raonka/Pack-Puck/data/analysis/2026-08-15_GMATownship_184714_qc/unassigned/report.md

# QC report — run `unassigned` (static)

- Session dir: `data/ranging_experiments/2026-08-15_GMATownship_session01/raw/20260815_184714-Initiator`
- Generated: 2026-09-10 23:37 UTC by qc_session.py v1.0.0 (raw CSVs read-only, unmodified)
- Expected config: 2400.0 MHz, BW 1625.0 kHz, SF8, CR 4/7, 12 dBm; N=100/file; cadence 655.0 ms ±5%; drift limit 15.0 m; warm-up window 5.0 s
- Ground truth: session plan `session_plan.json` (operator-supplied; used only where CSV line-2 TRUE_DISTANCE_M is absent)

## Verdict: **PASS**

No machine-checkable Methodology §11 discard trigger found in this run.

> The following Methodology §11 discard criteria are **not machine-checkable from CSVs** and must be confirmed against the session log: (a) cone moved mid-session without re-measurement; (b) material weather change mid-session (rain start, wind category shift). This tool checks only: firmware reboot / power-loss evidence (short or truncated files), and the >10-consecutive-ERROR abort criterion.

## 1. Manifest integrity

| file | manifest expected | manifest actual | on-disk | status | ok |
|---|---|---|---|---|---|
| `pucklog_D4DB1C_13.csv` | 237 | 237 | 237 | OK | ✓ |

## 2. Per-file checks

| file | truth (src) | N | vs spec | cadence ms | S / T / E (rate) | max ERR streak | drift m | flags |
|---|---|---|---|---|---|---|---|---|
| `pucklog_D4DB1C_13.csv` | — | 0 | -100 | — | 0 (0%) / 0 (0%) / 0 (0%) | 0 | — | 2 |

All three outcomes count toward the attempt denominator.

### radio_status_code distribution (non-SUCCESS rows)

No non-SUCCESS rows in this run.

## 3. Warm-up (first 5 s vs remainder, SUCCESS rows)

| file | warm-up rows | warm-up median m | rest median m | delta m |
|---|---|---|---|---|
| `pucklog_D4DB1C_13.csv` | — | — | — | — |

Sanity check for the Methodology §7.2 first-5-s discard rule; large deltas indicate the discard window matters for that file.

## 4. Per-marker statistics (SUCCESS rows)

No SUCCESS rows / no marker-attributable data.

## 5. Deviations and anomalies

- `pucklog_D4DB1C_13.csv`: operator metadata line (line 2) absent — SITE/RUN_ID/TRUE_DISTANCE_M not recorded in file (Methodology §7.4 step incomplete)
- `pucklog_D4DB1C_13.csv`: no data rows (stub file — likely a boot into NORMAL mode with no ranging logged)

overview
