raonka/Pack-Puck/data/analysis/aggregates.md

# Pack Pucks — Campaign aggregates

Generated by `tools/aggregates.py`. **Numbers only.**

## Inputs

- Current (post-discard): `data/analysis/2026-08-22_GMATownship_day2_tables_discard5s.md` — TABLE 2 (static), TABLE 3 (stop-and-go)
- Superseded (pre-discard, comparison only): `data/analysis/2026-08-22_GMATownship_day2_qc_tables.md` — TABLE 2, TABLE 3
- Raw Initiator CSVs (cadence, exchange total):
  - `data/ranging_experiments/2026-08-15_GMATownship_session01/raw/20260815_184714-Initiator/` — 2100 rows
  - `data/ranging_experiments/2026-08-22_GMATownship_session02/raw/20260822_162424-Initiator/` — 3100 rows
  - `data/ranging_experiments/2026-08-22_GMATownship_session02/raw/20260822_174415-Initiator/` — 2660 rows

Definitions: MAE = mean over the ten markers of |per-marker median − marker|. Signed bias = mean of the same signed errors. Mean IQR = mean of per-marker IQRs. Ratios = 406.25 value / 1625 value. Current column: MAE, signed bias and MAE ratio from the unrounded per-marker medians (`tools/per_marker_tables.py`); mean IQR, IQR ratio, ranges, counts and worst marker from the tables' 0.1 m-rounded values. Pre-discard column: all from the 0.1 m-rounded tables (reproduces README.md).

## Accuracy and precision (22 Aug, matched session)

| aggregate | tier | post-discard (current) | pre-discard | README.md | changed at README precision? |
|---|---|---|---|---|---|
| MAE, 406.25 kHz | static | 11.1 m | 11.1 m | 11.1 m | no |
| MAE, 1625 kHz | static | 1.6 m | 1.7 m | 1.7 m | **yes** |
| MAE ratio 406.25 / 1625 | static | 6.8× | 6.7× | 6.7× | **yes** |
| MAE, 406.25 kHz | s&g | 12.1 m | 12.1 m | 12.1 m | no |
| MAE, 1625 kHz | s&g | 1.7 m | 1.7 m | 1.7 m | no |
| MAE ratio 406.25 / 1625 | s&g | 7.2× | 7.1× | 7.1× | **yes** |
| Signed bias, 406.25 kHz | static | +10.4 m | +10.5 m | +10.5 m | **yes** |
| Signed bias, 1625 kHz | static | +0.4 m | +0.4 m | +0.4 m | no |
| Signed bias, 406.25 kHz | s&g | +12.1 m | +12.1 m | +12.1 m | no |
| Signed bias, 1625 kHz | s&g | -0.2 m | -0.2 m | −0.2 m | no |
| Mean IQR, 406.25 kHz | static | 5.2 m | 5.2 m | 5.2 m | no |
| Mean IQR, 1625 kHz | static | 1.7 m | 1.7 m | 1.7 m | no |
| Mean IQR ratio 406.25 / 1625 | static | 3.1× | 3.0× | 3.0× | **yes** |
| Mean IQR, 406.25 kHz | s&g | 4.4 m | 4.5 m | 4.5 m | **yes** |
| Mean IQR, 1625 kHz | s&g | 1.8 m | 1.8 m | 1.8 m | no |
| Mean IQR ratio 406.25 / 1625 | s&g | 2.5× | 2.6× | 2.6× | **yes** |
| Markers with positive error, 406.25 kHz | static | 9 of 10 | 9 of 10 | 9 of 10 | no |
| Markers with positive error, 406.25 kHz | s&g | 10 of 10 | 10 of 10 | 10 of 10 | no |
| Max |error|, 1625 kHz (README: "inside ±5 m at every marker") | static | 3.2 m | 3.2 m | < 5 m | no |
| Max |error|, 1625 kHz (README: "inside ±5 m at every marker") | s&g | 4.8 m | 4.8 m | < 5 m | no |
| Worst single marker, 406.25 kHz | static | +29.7 m (at 240 m) | +29.9 m (at 240 m) | +29.9 m (at 240 m) | **yes** |
| Worst single marker, 1625 kHz | static | +3.2 m (at 240 m) | +3.2 m (at 240 m) | +3.2 m (at 240 m) | no |
| Per-marker IQR range, 406.25 kHz | both | 2.8–9.1 m | 2.7–8.5 m | 2.7–8.5 m | **yes** |
| Per-marker IQR range, 1625 kHz | both | 1.0–3.3 m | 0.9–3.3 m | 0.9–3.3 m | **yes** |

## Cadence and exchange count (raw CSVs; not affected by the discard)

| aggregate | value | README.md |
|---|---|---|
| Cycle time, 1625 kHz (pooled median, 2649 inter-row deltas, 22 Aug) | 655 ms | 655 ms (2,649 deltas) |
| Cycle time, 406.25 kHz (pooled median, 3084 inter-row deltas, 22 Aug) | 686 ms | 686 ms (3,084 deltas) |
| Cycle time p05 / p95, 1625 kHz (linear interpolation) | 655 / 660 ms | — |
| Cycle time p05 / p95, 406.25 kHz (linear interpolation) | 685 / 691 ms | — |
| Cycle-time cost of 406.25 vs 1625 | 4.7 % | 4.7 % |
| Cycle-time difference, 406.25 − 1625 | 31 ms | — |
| Bandwidth-scaled part of the 1625 kHz cycle, if it scales with symbol duration (×4 at 406.25): (686 − 655) / 3 | 10.3 ms | — |
| Bandwidth-independent remainder of the 1625 kHz cycle | 644.7 ms (98.4%) | — |
| Span of a causal 3-reading filter window (current and two previous readings = 2 cycles), 1625 kHz | 1310 ms | — |
| Span of a causal 3-reading filter window (current and two previous readings = 2 cycles), 406.25 kHz | 1372 ms | — |
| Ranging exchanges, both campaign outings (all Initiator rows in the canonical offload sets, discarded retakes included) | 7,860 | 7,860 |

## Changed vs the pre-discard / README values (at README display precision; includes the discard and, for MAE / signed bias / MAE ratio, the switch to unrounded per-marker values)

- MAE, 1625 kHz (static): 1.7 m → 1.6 m
- MAE ratio 406.25 / 1625 (static): 6.7× → 6.8×
- MAE ratio 406.25 / 1625 (s&g): 7.1× → 7.2×
- Signed bias, 406.25 kHz (static): +10.5 m → +10.4 m
- Mean IQR ratio 406.25 / 1625 (static): 3.0× → 3.1×
- Mean IQR, 406.25 kHz (s&g): 4.5 m → 4.4 m
- Mean IQR ratio 406.25 / 1625 (s&g): 2.6× → 2.5×
- Worst single marker 406.25 (static): +29.9 m (at 240 m) → +29.7 m (at 240 m)
- IQR range 406.25 (both tiers): 2.7–8.5 m → 2.8–9.1 m
- IQR range 1625 (both tiers): 0.9–3.3 m → 1.0–3.3 m

## Signed error vs distance, 406.25 kHz: least-squares line (post-discard)

Input: `data/analysis/2026-08-22_GMATownship_day2_tables_discard5s.md` TABLE 2 (static) and TABLE 3 (stop-and-go), column "406 err", against marker distance. Model: signed error = intercept + slope × distance. Numbers only.

| tier | markers | n | slope (m/m) | slope standard error (m/m) | intercept (m) | \|slope\| < standard error? |
|---|---|---|---|---|---|---|
| static | all ten | 10 | +0.0079 | 0.0339 | +9.10 | yes |
| static | without 240 m | 9 | -0.0150 | 0.0233 | +10.61 | yes |
| stop-and-go | all ten | 10 | +0.0042 | 0.0142 | +11.39 | yes |
| stop-and-go | without 240 m | 9 | +0.0006 | 0.0152 | +11.62 | yes |
