raonka/Pack-Puck/data/analysis/2026-08-15_GMATownship_day1_tables_discard5s.md

# Pack Pucks — Day 1 per-marker tables, warm-up discarded (2026-08-15, GMA township, 1625 kHz only)

Generated by `tools/per_marker_tables.py` (raw CSVs read-only, unmodified).

**Numbers only. No interpretation or conclusions are recorded in this file.**

## Discard rule (Methodology §7.2, applied 2026-10-10)

Every row whose `timestamp_ms` is ≤ 5 s after the first logged row of its window is dropped before any statistic is computed. Static window = the whole file (one boot per marker). Stop-and-go window = one dwell (see the per-run notes). `N` = post-discard attempts, all outcomes. `median`, `IQR` (Q3−Q1, linear interpolation), `RSSI` = SUCCESS rows. `err` = median − marker distance.

## Inputs

- `data/ranging_experiments/2026-08-15_GMATownship_session01/raw/20260815_184714-Initiator/`
- `data/analysis/2026-08-15_GMATownship_184714_qc/session_plan.json`

Ground-truth tolerance: OPEN (Methodology §5.3, OD-METH-3); every signed-error figure carries it. Timeout and ERROR counts are 0 in every window.

Supersedes, for every per-marker number: §4 of `2026-08-15_GMATownship_184714_qc/static/report.md` and §5 of `…/stop_and_go/report.md` (both kept unmodified as QC output).

Stop-and-go windows are HEURISTIC (`qc_session.py` plateau segmentation, default parameters, identical to the published report) — no operator arrival log exists for this run (S1 log D2). Static: the 330 m file is an off-set marker (S1 log D5/D6); there is no 300 m static file.

---

### 1625 kHz — static

| marker m | file | N (post-discard) | median m | Q1–Q3 m | IQR m | signed err m | median RSSI |
|---|---|---|---|---|---|---|---|
| 30 | `pucklog_D4DB1C_1.csv` | 62 | 32.1 | 31.5–32.6 | 1.2 | +2.1 | -70 |
| 60 | `pucklog_D4DB1C_2.csv` | 52 | 59.5 | 59.0–60.2 | 1.1 | -0.5 | -72 |
| 90 | `pucklog_D4DB1C_3.csv` | 62 | 96.0 | 95.3–96.3 | 1.0 | +6.0 | -77 |
| 120 | `pucklog_D4DB1C_4.csv` | 62 | 117.3 | 117.0–118.0 | 1.1 | -2.7 | -81 |
| 150 | `pucklog_D4DB1C_6.csv` | 92 | 145.2 | 144.2–145.9 | 1.6 | -4.8 | -84 |
| 180 | `pucklog_D4DB1C_7.csv` | 62 | 176.8 | 176.0–177.5 | 1.5 | -3.2 | -84 |
| 210 | `pucklog_D4DB1C_8.csv` | 62 | 204.6 | 203.7–205.9 | 2.2 | -5.4 | -88 |
| 240 | `pucklog_D4DB1C_9.csv` | 62 | 243.5 | 241.5–247.3 | 5.8 | +3.5 | -90 |
| 270 | `pucklog_D4DB1C_10.csv` | 62 | 276.4 | 275.3–277.6 | 2.3 | +6.4 | -92 |
| 330 | `pucklog_D4DB1C_11.csv` | 102 | 318.7 | 316.2–320.3 | 4.1 | -11.3 | -94 |

### 1625 kHz — stop-and-go

| marker m | file | window s | N (post-discard) | median m | Q1–Q3 m | IQR m | signed err m | median RSSI |
|---|---|---|---|---|---|---|---|---|
| 30 | `pucklog_D4DB1C_12.csv` | 785.9–839.0 | 74 | 23.9 | 22.7–24.7 | 2.1 | -6.1 | -76 |
| 60 | `pucklog_D4DB1C_12.csv` | 691.4–753.8 | 88 | 61.0 | 60.3–61.5 | 1.1 | +1.0 | -73 |
| 90 | `pucklog_D4DB1C_12.csv` | 608.8–669.1 | 85 | 89.9 | 89.2–90.4 | 1.1 | -0.1 | -74 |
| 120 | `pucklog_D4DB1C_12.csv` | 543.8–589.8 | 63 | 115.4 | 114.7–116.3 | 1.7 | -4.6 | -77 |
| 150 | `pucklog_D4DB1C_12.csv` | 461.2–516.9 | 78 | 146.4 | 145.5–147.3 | 1.7 | -3.6 | -80 |
| 180 | `pucklog_D4DB1C_12.csv` | 373.3–433.6 | 85 | 177.3 | 176.1–178.1 | 2.0 | -2.7 | -83 |
| 210 | `pucklog_D4DB1C_12.csv` | 286.7–344.4 | 81 | 212.7 | 211.5–214.0 | 2.5 | +2.7 | -89 |
| 240 | `pucklog_D4DB1C_12.csv` | 242.7–270.3 | 35 | 239.2 | 237.4–241.9 | 4.5 | -0.8 | -90 |
| 270 | `pucklog_D4DB1C_12.csv` | 122.6–178.4 | 78 | 274.5 | 273.5–275.7 | 2.2 | +4.5 | -88 |
| 300 | `pucklog_D4DB1C_12.csv` | 0.0–108.9 | 159 | 296.8 | 295.8–297.8 | 2.0 | -3.2 | -90 |
