raonka/Pack-Puck/data/analysis/2026-08-22_GMATownship_day2_tables_discard5s.md

# Pack Pucks — Day 2 per-marker tables, warm-up discarded (2026-08-22, GMA township)

Generated by `tools/per_marker_tables.py` (raw CSVs read-only, unmodified).

**Numbers only. No interpretation or conclusions are recorded in this file.**

## Discard rule (Methodology §7.2, applied 2026-10-10)

Every row whose `timestamp_ms` is ≤ 5 s after the first logged row of its window is dropped before any statistic is computed. Static window = the whole file (one boot per marker). Stop-and-go window = one dwell (see the per-run notes). `N` = post-discard attempts, all outcomes. `median`, `IQR` (Q3−Q1, linear interpolation), `RSSI` = SUCCESS rows. `err` = median − marker distance.

## Inputs

- `data/ranging_experiments/2026-08-22_GMATownship_session02/raw/20260822_162424-Initiator/`
- `data/analysis/2026-08-22_GMATownship_162424_qc/session_plan.json`
- `data/ranging_experiments/2026-08-22_GMATownship_session02/stopwatch_laps_data_406.csv`
- `data/ranging_experiments/2026-08-22_GMATownship_session02/raw/20260822_174415-Initiator/`
- `data/analysis/2026-08-22_GMATownship_174415_qc/session_plan.json`
- `data/ranging_experiments/2026-08-22_GMATownship_session02/stopwatch_laps_data_1625.csv`

Ground-truth tolerance: OPEN (Methodology §5.3, OD-METH-3); every signed-error figure carries it. Timeout and ERROR counts are 0 in every window.

Supersedes, for every per-marker number: `data/analysis/2026-08-22_GMATownship_day2_qc_tables.md` (kept unmodified; its provenance, boundary-agreement, cadence and alignment sections are not regenerated here and remain the reference for those).

Stop-and-go dwell windows: dwell laps of the operator stopwatch sheet (spurious laps < 1 s dropped), file axis offset 0 s, single 300→30 descent. The 300 m window opens at boot; its discard counts from the first logged row (≈ 5.9 s).

---

### 406.25 kHz — static

| marker m | file | N (post-discard) | median m | Q1–Q3 m | IQR m | signed err m | median RSSI |
|---|---|---|---|---|---|---|---|
| 30 | `pucklog_D4DB1C_1.csv` | 92 | 38.9 | 37.2–40.9 | 3.7 | +8.9 | -66 |
| 60 | `pucklog_D4DB1C_2.csv` | 82 | 70.1 | 68.3–71.7 | 3.4 | +10.1 | -71 |
| 90 | `pucklog_D4DB1C_3.csv` | 82 | 99.3 | 97.0–101.3 | 4.3 | +9.3 | -72 |
| 120 | `pucklog_D4DB1C_5.csv` | 82 | 134.0 | 132.2–135.3 | 3.1 | +14.0 | -75 |
| 150 | `pucklog_D4DB1C_7.csv` | 102 | 162.1 | 160.0–164.2 | 4.1 | +12.1 | -79 |
| 180 | `pucklog_D4DB1C_8.csv` | 92 | 183.3 | 178.1–187.2 | 9.1 | +3.3 | -87 |
| 210 | `pucklog_D4DB1C_9.csv` | 92 | 206.7 | 202.9–210.2 | 7.2 | -3.3 | -87 |
| 240 | `pucklog_D4DB1C_11.csv` | 82 | 269.7 | 266.8–273.2 | 6.4 | +29.7 | -88 |
| 270 | `pucklog_D4DB1C_12.csv` | 82 | 285.3 | 282.1–288.5 | 6.4 | +15.3 | -89 |
| 300 | `pucklog_D4DB1C_14.csv` | 82 | 304.6 | 302.5–306.6 | 4.1 | +4.6 | -89 |

### 406.25 kHz — stop-and-go

| marker m | file | window s | N (post-discard) | median m | Q1–Q3 m | IQR m | signed err m | median RSSI |
|---|---|---|---|---|---|---|---|---|
| 30 | `pucklog_D4DB1C_18.csv` | 926.5–997.2 | 95 | 42.4 | 41.0–45.0 | 4.0 | +12.4 | -66 |
| 60 | `pucklog_D4DB1C_18.csv` | 822.7–897.4 | 101 | 72.6 | 70.4–74.6 | 4.2 | +12.6 | -72 |
| 90 | `pucklog_D4DB1C_18.csv` | 723.3–793.8 | 95 | 97.0 | 95.6–98.3 | 2.8 | +7.0 | -71 |
| 120 | `pucklog_D4DB1C_18.csv` | 622.8–693.2 | 94 | 128.8 | 127.4–130.7 | 3.3 | +8.8 | -76 |
| 150 | `pucklog_D4DB1C_18.csv` | 523.6–594.2 | 95 | 163.7 | 162.0–165.0 | 3.0 | +13.7 | -77 |
| 180 | `pucklog_D4DB1C_18.csv` | 423.4–493.8 | 95 | 199.6 | 197.6–201.2 | 3.7 | +19.6 | -83 |
| 210 | `pucklog_D4DB1C_18.csv` | 325.2–396.2 | 95 | 219.6 | 215.0–222.7 | 7.7 | +9.6 | -85 |
| 240 | `pucklog_D4DB1C_18.csv` | 219.8–290.4 | 95 | 255.3 | 252.4–258.7 | 6.2 | +15.3 | -86 |
| 270 | `pucklog_D4DB1C_18.csv` | 105.6–176.2 | 95 | 282.7 | 280.9–285.7 | 4.8 | +12.7 | -88 |
| 300 | `pucklog_D4DB1C_18.csv` | 0.0–70.8 | 87 | 309.1 | 307.1–311.6 | 4.5 | +9.1 | -87 |

### 1625 kHz — static

| marker m | file | N (post-discard) | median m | Q1–Q3 m | IQR m | signed err m | median RSSI |
|---|---|---|---|---|---|---|---|
| 30 | `pucklog_D4DB1C_1.csv` | 92 | 29.8 | 29.3–30.3 | 1.0 | -0.2 | -70 |
| 60 | `pucklog_D4DB1C_2.csv` | 92 | 60.4 | 59.8–61.0 | 1.2 | +0.4 | -75 |
| 90 | `pucklog_D4DB1C_3.csv` | 102 | 87.0 | 86.2–88.3 | 2.0 | -3.0 | -75 |
| 120 | `pucklog_D4DB1C_4.csv` | 102 | 121.9 | 121.3–122.4 | 1.1 | +1.9 | -77 |
| 150 | `pucklog_D4DB1C_5.csv` | 102 | 147.4 | 146.8–148.1 | 1.3 | -2.6 | -80 |
| 180 | `pucklog_D4DB1C_6.csv` | 102 | 181.2 | 180.2–181.9 | 1.6 | +1.2 | -82 |
| 210 | `pucklog_D4DB1C_7.csv` | 102 | 210.5 | 209.6–211.4 | 1.8 | +0.5 | -86 |
| 240 | `pucklog_D4DB1C_8.csv` | 102 | 243.2 | 242.0–244.8 | 2.8 | +3.2 | -89 |
| 270 | `pucklog_D4DB1C_9.csv` | 102 | 272.9 | 271.9–273.7 | 1.8 | +2.9 | -90 |
| 300 | `pucklog_D4DB1C_10.csv` | 122 | 299.4 | 298.4–300.4 | 2.0 | -0.6 | -90 |

### 1625 kHz — stop-and-go

| marker m | file | window s | N (post-discard) | median m | Q1–Q3 m | IQR m | signed err m | median RSSI |
|---|---|---|---|---|---|---|---|---|
| 30 | `pucklog_D4DB1C_11.csv` | 923.4–995.0 | 102 | 29.0 | 28.5–29.5 | 1.0 | -1.0 | -72 |
| 60 | `pucklog_D4DB1C_11.csv` | 819.8–891.5 | 102 | 55.9 | 54.9–56.9 | 2.0 | -4.1 | -75 |
| 90 | `pucklog_D4DB1C_11.csv` | 720.8–791.3 | 99 | 90.8 | 90.1–91.4 | 1.3 | +0.8 | -76 |
| 120 | `pucklog_D4DB1C_11.csv` | 618.2–688.9 | 100 | 118.4 | 117.8–118.9 | 1.1 | -1.6 | -79 |
| 150 | `pucklog_D4DB1C_11.csv` | 518.6–589.3 | 100 | 148.5 | 147.9–149.5 | 1.6 | -1.5 | -81 |
| 180 | `pucklog_D4DB1C_11.csv` | 407.6–479.0 | 101 | 179.1 | 178.3–180.4 | 2.1 | -0.9 | -85 |
| 210 | `pucklog_D4DB1C_11.csv` | 302.6–374.2 | 101 | 211.3 | 210.8–211.9 | 1.1 | +1.3 | -87 |
| 240 | `pucklog_D4DB1C_11.csv` | 201.3–272.4 | 100 | 240.6 | 238.9–242.2 | 3.3 | +0.6 | -88 |
| 270 | `pucklog_D4DB1C_11.csv` | 99.8–170.3 | 99 | 274.8 | 274.2–275.5 | 1.3 | +4.8 | -88 |
| 300 | `pucklog_D4DB1C_11.csv` | 0.0–70.8 | 91 | 299.8 | 298.5–301.4 | 2.9 | -0.2 | -90 |

---

## TABLE 1 — Per-marker, each day-2 run (post-discard)

| marker m | 406.25 static med | IQR | err | N | RSSI | 406.25 s&g med | IQR | err | N | RSSI | 1625 static med | IQR | err | N | RSSI | 1625 s&g med | IQR | err | N | RSSI |
|---|---|---|---|---|---|---|---|---|---|---|---|---|---|---|---|---|---|---|---|---|
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
| 210 | -3.3 | +9.6 | -12.9 | +0.5 | +1.3 | -0.8 |
| 240 | +29.7 | +15.3 | +14.4 | +3.2 | +0.6 | +2.6 |
| 270 | +15.3 | +12.7 | +2.6 | +2.9 | +4.8 | -2.0 |
| 300 | +4.6 | +9.1 | -4.5 | -0.6 | -0.2 | -0.4 |

## TABLE 5 — 1625 continuity: day 1 (15 Aug) vs day 2 (22 Aug), STATIC (post-discard)

| marker m | D1 med | D1 IQR | D1 err | D1 N | D2 med | D2 IQR | D2 err | D2 N | err drift |
|---|---|---|---|---|---|---|---|---|---|
| 30 | 32.1 | 1.2 | +2.1 | 62 | 29.8 | 1.0 | -0.2 | 92 | -2.3 |
| 60 | 59.5 | 1.1 | -0.5 | 52 | 60.4 | 1.2 | +0.4 | 92 | +0.8 |
| 90 | 96.0 | 1.0 | +6.0 | 62 | 87.0 | 2.0 | -3.0 | 102 | -9.0 |
| 120 | 117.3 | 1.1 | -2.7 | 62 | 121.9 | 1.1 | +1.9 | 102 | +4.6 |
| 150 | 145.2 | 1.6 | -4.8 | 92 | 147.4 | 1.3 | -2.6 | 102 | +2.3 |
| 180 | 176.8 | 1.5 | -3.2 | 62 | 181.2 | 1.6 | +1.2 | 102 | +4.3 |
| 210 | 204.6 | 2.2 | -5.4 | 62 | 210.5 | 1.8 | +0.5 | 102 | +5.9 |
| 240 | 243.5 | 5.8 | +3.5 | 62 | 243.2 | 2.8 | +3.2 | 102 | -0.3 |
| 270 | 276.4 | 2.3 | +6.4 | 62 | 272.9 | 1.8 | +2.9 | 102 | -3.6 |
| 300 | — | — | — | — | 299.4 | 2.0 | -0.6 | 122 | — |
