raonka/Pack-Puck/data/analysis/achieved_n.md

# Pack Pucks — Achieved N per marker (post-discard)

Generated by `tools/per_marker_tables.py` from the raw CSVs, after the Methodology §7.2 first-5-s discard. N = attempts (all outcomes) remaining per marker per run. Every attempt in both outings was SUCCESS (0 TIMEOUT, 0 ERROR).

Sources: `data/analysis/2026-08-22_GMATownship_day2_tables_discard5s.md`, `data/analysis/2026-08-15_GMATownship_day1_tables_discard5s.md` (same computation; see their Inputs sections).

| session | BW kHz | tier | 30 m | 60 m | 90 m | 120 m | 150 m | 180 m | 210 m | 240 m | 270 m | 300 m | 330 m | min N |
|---|---|---|---|---|---|---|---|---|---|---|---|---|---|---|
| 22 Aug | 406.25 | static | 92 | 82 | 82 | 82 | 102 | 92 | 92 | 82 | 82 | 82 | — | **82** |
| 22 Aug | 406.25 | stop-and-go | 95 | 101 | 95 | 94 | 95 | 95 | 95 | 95 | 95 | 87 | — | **87** |
| 22 Aug | 1625 | static | 92 | 92 | 102 | 102 | 102 | 102 | 102 | 102 | 102 | 122 | — | **92** |
| 22 Aug | 1625 | stop-and-go | 102 | 102 | 99 | 100 | 100 | 101 | 101 | 100 | 99 | 91 | — | **91** |
| 15 Aug | 1625 | static | 62 | 52 | 62 | 62 | 92 | 62 | 62 | 62 | 62 | — | 102 | **52** |
| 15 Aug | 1625 | stop-and-go | 74 | 88 | 85 | 63 | 78 | 85 | 81 | 35 | 78 | 159 | — | **35** |

- **N_min, 22 Aug (all four runs): 82**
- N_min, 15 Aug (both runs): 35
- **N_min overall: 35**

15 Aug stop-and-go N comes from heuristic dwell windows (no arrival log). The 330 m column is the 15 Aug off-set static marker only.
