raonka/Pack-Puck/data/analysis/c3_filters.md

# Pack Pucks — C3 post-hoc filter characterisation (22 Aug 2026)

Generated by `tools/c3_filters.py`. **Numbers and descriptions only; no filter is ranked or recommended**.

## Inputs and method

- Windows and discard: `tools/per_marker_tables.py`, i.e. the rows behind `data/analysis/2026-08-22_GMATownship_day2_tables_discard5s.md` (Methodology §7.2 first-5-s discard; stop-and-go = lap-log dwell windows).
- Raw CSVs: `data/ranging_experiments/2026-08-22_GMATownship_session02/raw/20260822_162424-Initiator/`, `data/ranging_experiments/2026-08-22_GMATownship_session02/raw/20260822_174415-Initiator/`.
- **Filters.** SUCCESS readings in time order; sliding window of 3 consecutive readings, full windows only (no padding). Raw = N outputs; median-of-3 and max-of-3 = N − 2 outputs.
- **Per-marker summary** of each filter's output: median, signed error = median − marker, IQR (Q3 − Q1, linear interpolation), N = number of outputs.
- **Aggregates** are unweighted means over the ten markers: MAE = mean |error|, mean signed bias, mean IQR. They are computed from unrounded values, so they can differ in the last digit from aggregates computed on the 0.1 m-rounded tables (`aggregates.md`).
- The raw path reproduces the post-discard tables' median and IQR at every marker (asserted by the script).
- Ground truth: ±0.5 m at 300 m (Methodology §5.3); cone-position error is common to every filter and both bandwidths.

## Aggregates per bandwidth × tier

| BW kHz | tier | filter | MAE m | mean signed bias m | mean IQR m |
|---|---|---|---|---|---|
| 406.25 | static | raw | 11.09 | +10.42 | 5.20 |
| 406.25 | static | median-of-3 | 11.14 | +10.49 | 4.70 |
| 406.25 | static | max-of-3 | 12.98 | +12.85 | 4.91 |
| 406.25 | stop-and-go | raw | 12.07 | +12.07 | 4.42 |
| 406.25 | stop-and-go | median-of-3 | 12.11 | +12.11 | 3.61 |
| 406.25 | stop-and-go | max-of-3 | 14.59 | +14.59 | 3.36 |
| 1625 | static | raw | 1.63 | +0.36 | 1.67 |
| 1625 | static | median-of-3 | 1.63 | +0.35 | 1.25 |
| 1625 | static | max-of-3 | 1.99 | +1.21 | 1.25 |
| 1625 | stop-and-go | raw | 1.67 | -0.17 | 1.77 |
| 1625 | stop-and-go | median-of-3 | 1.64 | -0.14 | 1.36 |
| 1625 | stop-and-go | max-of-3 | 1.71 | +0.78 | 1.42 |

## Where each filter changes bias and spread (relative to raw)

Δ = filter − raw, per marker. Thresholds of ±0.05 m are used only to count markers.

### 406.25 kHz — static

- **median-of-3** vs raw. *Bias:* signed error moves by -0.09 to +0.45 m per marker (higher at 4, lower at 1, within ±0.05 m at 5 of 10 markers); mean signed bias +10.42 → +10.49 m. *Spread:* IQR moves by -1.69 to +0.25 m (narrower at 9, wider at 1, within ±0.05 m at 0); mean IQR 5.20 → 4.70 m.
- **max-of-3** vs raw. *Bias:* signed error moves by +1.76 to +3.20 m per marker (higher at 10, lower at 0, within ±0.05 m at 0 of 10 markers); mean signed bias +10.42 → +12.85 m. *Spread:* IQR moves by -1.31 to +1.01 m (narrower at 6, wider at 3, within ±0.05 m at 1); mean IQR 5.20 → 4.91 m.

### 406.25 kHz — stop-and-go

- **median-of-3** vs raw. *Bias:* signed error moves by -0.36 to +0.54 m per marker (higher at 3, lower at 1, within ±0.05 m at 6 of 10 markers); mean signed bias +12.07 → +12.11 m. *Spread:* IQR moves by -1.49 to +0.41 m (narrower at 9, wider at 1, within ±0.05 m at 0); mean IQR 4.42 → 3.61 m.
- **max-of-3** vs raw. *Bias:* signed error moves by +1.44 to +3.70 m per marker (higher at 10, lower at 0, within ±0.05 m at 0 of 10 markers); mean signed bias +12.07 → +14.59 m. *Spread:* IQR moves by -2.03 to -0.41 m (narrower at 10, wider at 0, within ±0.05 m at 0); mean IQR 4.42 → 3.36 m.

### 1625 kHz — static

- **median-of-3** vs raw. *Bias:* signed error moves by -0.18 to +0.10 m per marker (higher at 2, lower at 3, within ±0.05 m at 5 of 10 markers); mean signed bias +0.36 → +0.35 m. *Spread:* IQR moves by -0.91 to +0.12 m (narrower at 9, wider at 1, within ±0.05 m at 0); mean IQR 1.67 → 1.25 m.
- **max-of-3** vs raw. *Bias:* signed error moves by +0.54 to +1.46 m per marker (higher at 10, lower at 0, within ±0.05 m at 0 of 10 markers); mean signed bias +0.36 → +1.21 m. *Spread:* IQR moves by -1.09 to +0.23 m (narrower at 8, wider at 1, within ±0.05 m at 1); mean IQR 1.67 → 1.25 m.

### 1625 kHz — stop-and-go

- **median-of-3** vs raw. *Bias:* signed error moves by -0.02 to +0.15 m per marker (higher at 3, lower at 0, within ±0.05 m at 7 of 10 markers); mean signed bias -0.17 → -0.14 m. *Spread:* IQR moves by -0.66 to -0.16 m (narrower at 10, wider at 0, within ±0.05 m at 0); mean IQR 1.77 → 1.36 m.
- **max-of-3** vs raw. *Bias:* signed error moves by +0.57 to +1.67 m per marker (higher at 10, lower at 0, within ±0.05 m at 0 of 10 markers); mean signed bias -0.17 → +0.78 m. *Spread:* IQR moves by -1.09 to +0.09 m (narrower at 8, wider at 1, within ±0.05 m at 1); mean IQR 1.77 → 1.42 m.

## Order-statistic check for max-of-3

For three independent normal readings with standard deviation σ, the expected maximum lies 0.846 σ above the mean. Predicted shift = 0.846 × σ, where σ = sample standard deviation of the post-discard raw readings at that marker. Observed shift = max-of-3 median − raw median. σ is used for this check only; it is not a reported statistic (the paper reports median and IQR). Pass band: observed run mean within ±40% of predicted run mean. (For the *median* of the max, the normal-theory factor is 0.82 rather than 0.846; the pass band covers the difference.)

| BW kHz | tier | mean σ m | mean predicted shift m | mean observed shift m | observed / predicted | per-marker ratio range | within ±40%? |
|---|---|---|---|---|---|---|---|
| 406.25 | static | 3.85 | 3.25 | 2.44 | 0.75 | 0.54–1.15 | yes |
| 406.25 | stop-and-go | 2.99 | 2.53 | 2.52 | 0.99 | 0.65–1.29 | yes |
| 1625 | static | 1.35 | 1.15 | 0.85 | 0.74 | 0.48–0.96 | yes |
| 1625 | stop-and-go | 1.29 | 1.09 | 0.95 | 0.87 | 0.65–1.33 | yes |

**Result: PASS** — the observed max-of-3 shift is within ±40% of the order-statistic prediction in every run.

## Per-marker results

### 406.25 kHz — static

| marker m | raw median | raw err | raw IQR | raw N | med3 median | med3 err | med3 IQR | med3 N | max3 median | max3 err | max3 IQR | max3 N |
|---|---|---|---|---|---|---|---|---|---|---|---|---|
| 30 | 38.9 | +8.9 | 3.7 | 92 | 38.9 | +8.9 | 2.7 | 90 | 41.6 | +11.6 | 3.7 | 90 |
| 60 | 70.1 | +10.1 | 3.4 | 82 | 70.0 | +10.0 | 2.4 | 80 | 71.9 | +11.9 | 2.7 | 80 |
| 90 | 99.3 | +9.3 | 4.3 | 82 | 99.3 | +9.3 | 4.0 | 80 | 101.4 | +11.4 | 4.8 | 80 |
| 120 | 134.0 | +14.0 | 3.1 | 82 | 134.1 | +14.1 | 2.9 | 80 | 136.0 | +16.0 | 2.7 | 80 |
| 150 | 162.1 | +12.1 | 4.1 | 102 | 162.1 | +12.1 | 4.0 | 100 | 163.9 | +13.9 | 3.4 | 100 |
| 180 | 183.3 | +3.3 | 9.1 | 92 | 183.8 | +3.8 | 8.8 | 90 | 186.4 | +6.4 | 9.2 | 90 |
| 210 | 206.7 | -3.3 | 7.2 | 92 | 206.7 | -3.3 | 6.9 | 90 | 209.4 | -0.6 | 6.8 | 90 |
| 240 | 269.7 | +29.7 | 6.4 | 82 | 269.9 | +29.9 | 6.1 | 80 | 272.8 | +32.8 | 7.4 | 80 |
| 270 | 285.3 | +15.3 | 6.4 | 82 | 285.3 | +15.3 | 6.7 | 80 | 288.5 | +18.5 | 5.5 | 80 |
| 300 | 304.6 | +4.6 | 4.1 | 82 | 304.7 | +4.7 | 2.4 | 80 | 306.8 | +6.8 | 2.8 | 80 |

### 406.25 kHz — stop-and-go

| marker m | raw median | raw err | raw IQR | raw N | med3 median | med3 err | med3 IQR | med3 N | max3 median | max3 err | max3 IQR | max3 N |
|---|---|---|---|---|---|---|---|---|---|---|---|---|
| 30 | 42.4 | +12.4 | 4.0 | 95 | 42.4 | +12.4 | 2.7 | 93 | 45.6 | +15.6 | 3.5 | 93 |
| 60 | 72.6 | +12.6 | 4.2 | 101 | 72.7 | +12.7 | 3.2 | 99 | 75.0 | +15.0 | 2.8 | 99 |
| 90 | 97.0 | +7.0 | 2.8 | 95 | 97.0 | +7.0 | 2.1 | 93 | 99.0 | +9.0 | 2.1 | 93 |
| 120 | 128.8 | +8.8 | 3.3 | 94 | 128.8 | +8.8 | 1.8 | 92 | 130.8 | +10.8 | 2.9 | 92 |
| 150 | 163.7 | +13.7 | 3.0 | 95 | 163.7 | +13.7 | 2.1 | 93 | 165.1 | +15.1 | 1.5 | 93 |
| 180 | 199.6 | +19.6 | 3.7 | 95 | 199.2 | +19.2 | 2.3 | 93 | 201.4 | +21.4 | 1.6 | 93 |
| 210 | 219.6 | +9.6 | 7.7 | 95 | 220.1 | +10.1 | 8.1 | 93 | 222.3 | +12.3 | 6.8 | 93 |
| 240 | 255.3 | +15.3 | 6.2 | 95 | 255.4 | +15.4 | 5.8 | 93 | 259.0 | +19.0 | 5.0 | 93 |
| 270 | 282.7 | +12.7 | 4.8 | 95 | 282.7 | +12.7 | 4.4 | 93 | 285.4 | +15.4 | 4.1 | 93 |
| 300 | 309.1 | +9.1 | 4.5 | 87 | 309.1 | +9.1 | 3.6 | 85 | 312.3 | +12.3 | 3.2 | 85 |

### 1625 kHz — static

| marker m | raw median | raw err | raw IQR | raw N | med3 median | med3 err | med3 IQR | med3 N | max3 median | max3 err | max3 IQR | max3 N |
|---|---|---|---|---|---|---|---|---|---|---|---|---|
| 30 | 29.8 | -0.2 | 1.0 | 92 | 29.8 | -0.2 | 0.7 | 90 | 30.4 | +0.4 | 0.7 | 90 |
| 60 | 60.4 | +0.4 | 1.2 | 92 | 60.4 | +0.4 | 0.9 | 90 | 61.0 | +1.0 | 0.7 | 90 |
| 90 | 87.0 | -3.0 | 2.0 | 102 | 87.0 | -3.0 | 2.1 | 100 | 87.9 | -2.1 | 2.2 | 100 |
| 120 | 121.9 | +1.9 | 1.1 | 102 | 121.9 | +1.9 | 0.8 | 100 | 122.4 | +2.4 | 0.9 | 100 |
| 150 | 147.4 | -2.6 | 1.3 | 102 | 147.5 | -2.5 | 0.8 | 100 | 148.2 | -1.8 | 1.3 | 100 |
| 180 | 181.2 | +1.2 | 1.6 | 102 | 181.3 | +1.3 | 0.9 | 100 | 181.9 | +1.9 | 0.7 | 100 |
| 210 | 210.5 | +0.5 | 1.8 | 102 | 210.5 | +0.5 | 1.4 | 100 | 211.5 | +1.5 | 1.3 | 100 |
| 240 | 243.2 | +3.2 | 2.8 | 102 | 243.0 | +3.0 | 2.3 | 100 | 244.6 | +4.6 | 1.8 | 100 |
| 270 | 272.9 | +2.9 | 1.8 | 102 | 272.9 | +2.9 | 0.9 | 100 | 273.8 | +3.8 | 1.6 | 100 |
| 300 | 299.4 | -0.6 | 2.0 | 122 | 299.3 | -0.7 | 1.8 | 120 | 300.3 | +0.3 | 1.5 | 120 |

### 1625 kHz — stop-and-go

| marker m | raw median | raw err | raw IQR | raw N | med3 median | med3 err | med3 IQR | med3 N | max3 median | max3 err | max3 IQR | max3 N |
|---|---|---|---|---|---|---|---|---|---|---|---|---|
| 30 | 29.0 | -1.0 | 1.0 | 102 | 29.0 | -1.0 | 0.8 | 100 | 29.6 | -0.4 | 0.8 | 100 |
| 60 | 55.9 | -4.1 | 2.0 | 102 | 56.0 | -4.0 | 1.5 | 100 | 56.9 | -3.1 | 1.4 | 100 |
| 90 | 90.8 | +0.8 | 1.3 | 99 | 90.8 | +0.8 | 0.7 | 97 | 91.5 | +1.5 | 0.9 | 97 |
| 120 | 118.4 | -1.6 | 1.1 | 100 | 118.3 | -1.7 | 0.7 | 98 | 119.2 | -0.8 | 0.9 | 98 |
| 150 | 148.5 | -1.5 | 1.6 | 100 | 148.6 | -1.4 | 1.1 | 98 | 149.6 | -0.4 | 1.4 | 98 |
| 180 | 179.1 | -0.9 | 2.1 | 101 | 179.2 | -0.8 | 1.9 | 99 | 180.8 | +0.8 | 2.0 | 99 |
| 210 | 211.3 | +1.3 | 1.1 | 101 | 211.3 | +1.3 | 0.9 | 99 | 212.0 | +2.0 | 1.2 | 99 |
| 240 | 240.6 | +0.6 | 3.3 | 100 | 240.6 | +0.6 | 2.6 | 98 | 241.8 | +1.8 | 2.2 | 98 |
| 270 | 274.8 | +4.8 | 1.3 | 99 | 274.8 | +4.8 | 0.9 | 97 | 275.5 | +5.5 | 1.4 | 97 |
| 300 | 299.8 | -0.2 | 2.9 | 91 | 299.8 | -0.2 | 2.5 | 89 | 300.9 | +0.9 | 2.0 | 89 |
