raonka/Pack-Puck/data/analysis/f4_discard_delta.md

# Warm-up discard: old vs new per-marker medians and IQRs

Generated by `tools/per_marker_tables.py`. Numbers only.

"Old" = no discard, recomputed by the same script and verified equal (median, IQR to 0.1 m; N exact) to the published values at every marker of every run. "New" = first 5 s of each window discarded (Methodology §7.2). Δ = new − old.

## Which files supersede which

| Superseded (kept unmodified) | Superseded by |
|---|---|
| `data/analysis/2026-08-22_GMATownship_day2_qc_tables.md` — per-marker stats (lap-window tables, TABLE 1–5) | `data/analysis/2026-08-22_GMATownship_day2_tables_discard5s.md` |
| `data/analysis/2026-08-22_GMATownship_{162424,174415}_qc/*/report.md` §4 / §5 per-marker stats | same (day-2 discard5s file) |
| `data/analysis/2026-08-15_GMATownship_184714_qc/{static,stop_and_go}/report.md` §4 / §5 per-marker stats | `data/analysis/2026-08-15_GMATownship_day1_tables_discard5s.md` |
| `data/analysis/2026-08-22_GMATownship_day2_qc_tables.md` — provenance, boundary agreement, alignment, cadence | NOT superseded (not affected by the discard) |
| QC verdicts, drift checks, manifests in every `report.md` | NOT superseded |

`tools/make_readme_figures.py` reads the post-discard day-2 file and writes `data/analysis/figures/*_discard5s.png` beside the pre-discard figures, which README.md still embeds.

## 22 Aug — 406.25 kHz — static

| marker m | old N | new N | old median | new median | Δ median | old IQR | new IQR | Δ IQR | old err | new err |
|---|---|---|---|---|---|---|---|---|---|---|
| 30 | 100 | 92 | 38.9 | 38.9 | +0.1 | 3.6 | 3.7 | +0.1 | +8.9 | +8.9 |
| 60 | 90 | 82 | 70.3 | 70.1 | -0.2 | 3.4 | 3.4 | +0.1 | +10.3 | +10.1 |
| 90 | 90 | 82 | 99.3 | 99.3 | +0.0 | 4.2 | 4.3 | +0.1 | +9.3 | +9.3 |
| 120 | 90 | 82 | 134.0 | 134.0 | +0.0 | 3.4 | 3.1 | -0.2 | +14.0 | +14.0 |
| 150 | 110 | 102 | 161.9 | 162.1 | +0.2 | 4.3 | 4.1 | -0.2 | +11.9 | +12.1 |
| 180 | 100 | 92 | 184.0 | 183.3 | -0.7 | 8.5 | 9.1 | +0.6 | +4.0 | +3.3 |
| 210 | 100 | 92 | 207.3 | 206.7 | -0.6 | 7.3 | 7.2 | -0.0 | -2.7 | -3.3 |
| 240 | 90 | 82 | 269.9 | 269.7 | -0.2 | 6.3 | 6.4 | +0.1 | +29.9 | +29.7 |
| 270 | 90 | 82 | 285.0 | 285.3 | +0.2 | 6.3 | 6.4 | +0.1 | +15.0 | +15.3 |
| 300 | 90 | 82 | 304.6 | 304.6 | +0.0 | 4.3 | 4.1 | -0.2 | +4.6 | +4.6 |

Largest |Δ median| 0.72 m; largest |Δ IQR| 0.63 m.

## 22 Aug — 406.25 kHz — stop-and-go

| marker m | old N | new N | old median | new median | Δ median | old IQR | new IQR | Δ IQR | old err | new err |
|---|---|---|---|---|---|---|---|---|---|---|
| 30 | 103 | 95 | 42.5 | 42.4 | -0.2 | 4.1 | 4.0 | -0.1 | +12.5 | +12.4 |
| 60 | 109 | 101 | 72.6 | 72.6 | +0.0 | 4.5 | 4.2 | -0.3 | +12.6 | +12.6 |
| 90 | 103 | 95 | 97.0 | 97.0 | +0.0 | 2.7 | 2.8 | +0.1 | +7.0 | +7.0 |
| 120 | 102 | 94 | 128.8 | 128.8 | +0.0 | 3.3 | 3.3 | +0.0 | +8.8 | +8.8 |
| 150 | 103 | 95 | 163.9 | 163.7 | -0.2 | 2.9 | 3.0 | +0.1 | +13.9 | +13.7 |
| 180 | 103 | 95 | 199.6 | 199.6 | +0.0 | 3.7 | 3.7 | +0.0 | +19.6 | +19.6 |
| 210 | 103 | 95 | 219.1 | 219.6 | +0.5 | 7.8 | 7.7 | -0.1 | +9.1 | +9.6 |
| 240 | 103 | 95 | 255.6 | 255.3 | -0.4 | 6.4 | 6.2 | -0.1 | +15.6 | +15.3 |
| 270 | 103 | 95 | 282.6 | 282.7 | +0.1 | 4.7 | 4.8 | +0.0 | +12.6 | +12.7 |
| 300 | 95 | 87 | 309.5 | 309.1 | -0.4 | 4.6 | 4.5 | -0.1 | +9.5 | +9.1 |

Largest |Δ median| 0.45 m; largest |Δ IQR| 0.27 m.

## 22 Aug — 1625 kHz — static

| marker m | old N | new N | old median | new median | Δ median | old IQR | new IQR | Δ IQR | old err | new err |
|---|---|---|---|---|---|---|---|---|---|---|
| 30 | 100 | 92 | 29.8 | 29.8 | -0.0 | 1.1 | 1.0 | -0.1 | -0.2 | -0.2 |
| 60 | 100 | 92 | 60.4 | 60.4 | -0.0 | 1.2 | 1.2 | +0.0 | +0.4 | +0.4 |
| 90 | 110 | 102 | 87.1 | 87.0 | -0.0 | 2.0 | 2.0 | -0.0 | -2.9 | -3.0 |
| 120 | 110 | 102 | 121.9 | 121.9 | +0.0 | 1.1 | 1.1 | -0.0 | +1.9 | +1.9 |
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
| 240 | 43 | 35 | 239.9 | 239.2 | -0.7 | 4.6 | 4.5 | -0.1 | -0.1 | -0.8 |
| 270 | 86 | 78 | 274.6 | 274.5 | -0.1 | 2.3 | 2.2 | -0.1 | +4.6 | +4.5 |
| 300 | 167 | 159 | 296.8 | 296.8 | -0.0 | 2.1 | 2.0 | -0.0 | -3.2 | -3.2 |

Largest |Δ median| 0.72 m; largest |Δ IQR| 0.21 m.
