raonka/Pack-Puck/data/analysis/figures/bandwidth_accuracy_discard5s_paper.png

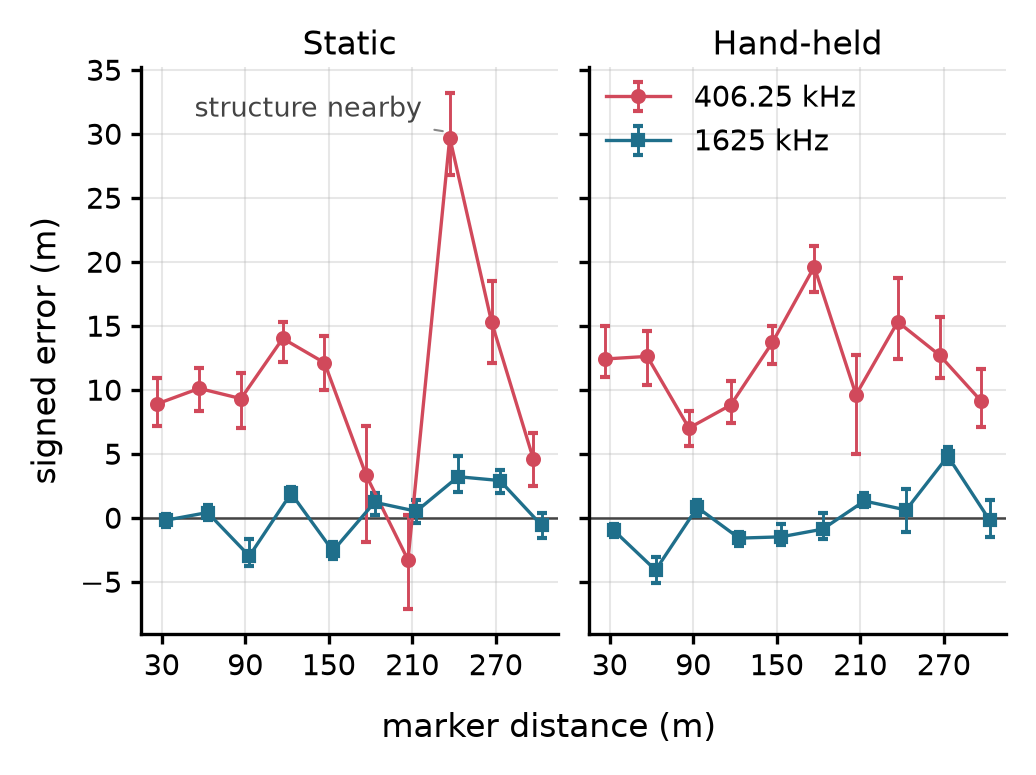
data/analysis/figures/bandwidth_accuracy_discard5s_paper.png
