raonka/Pack-Puck/data/analysis/figures/bandwidth_precision.png

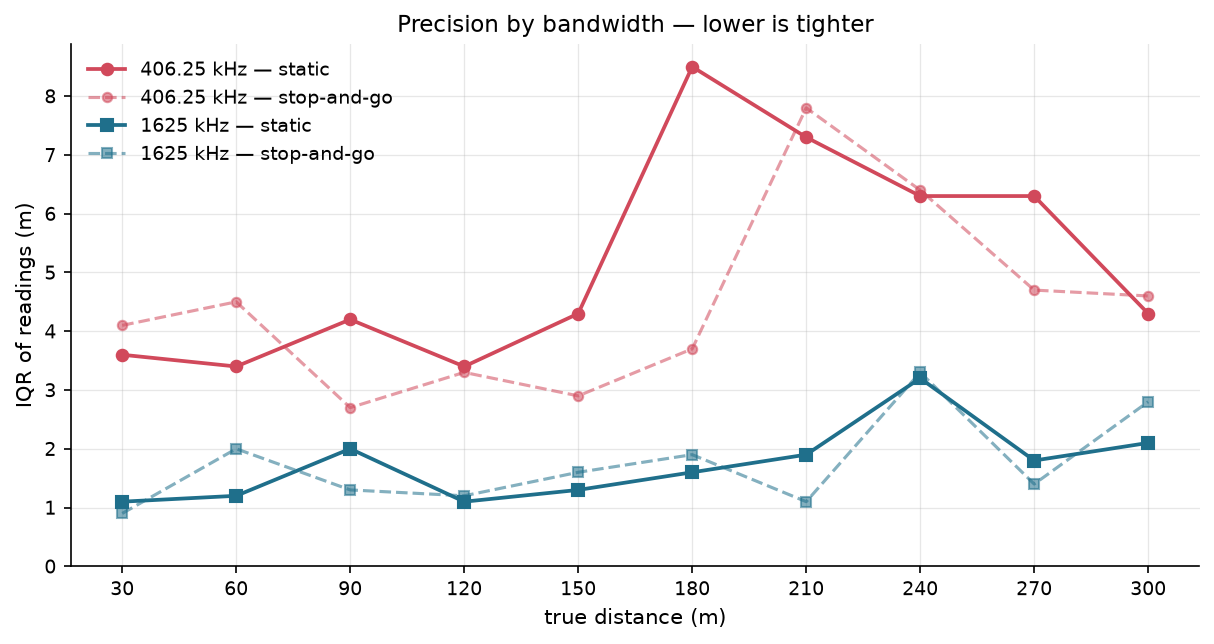
data/analysis/figures/bandwidth_precision.png
