raonka/Pack-Puck/data/analysis/figures/c2_walking.png

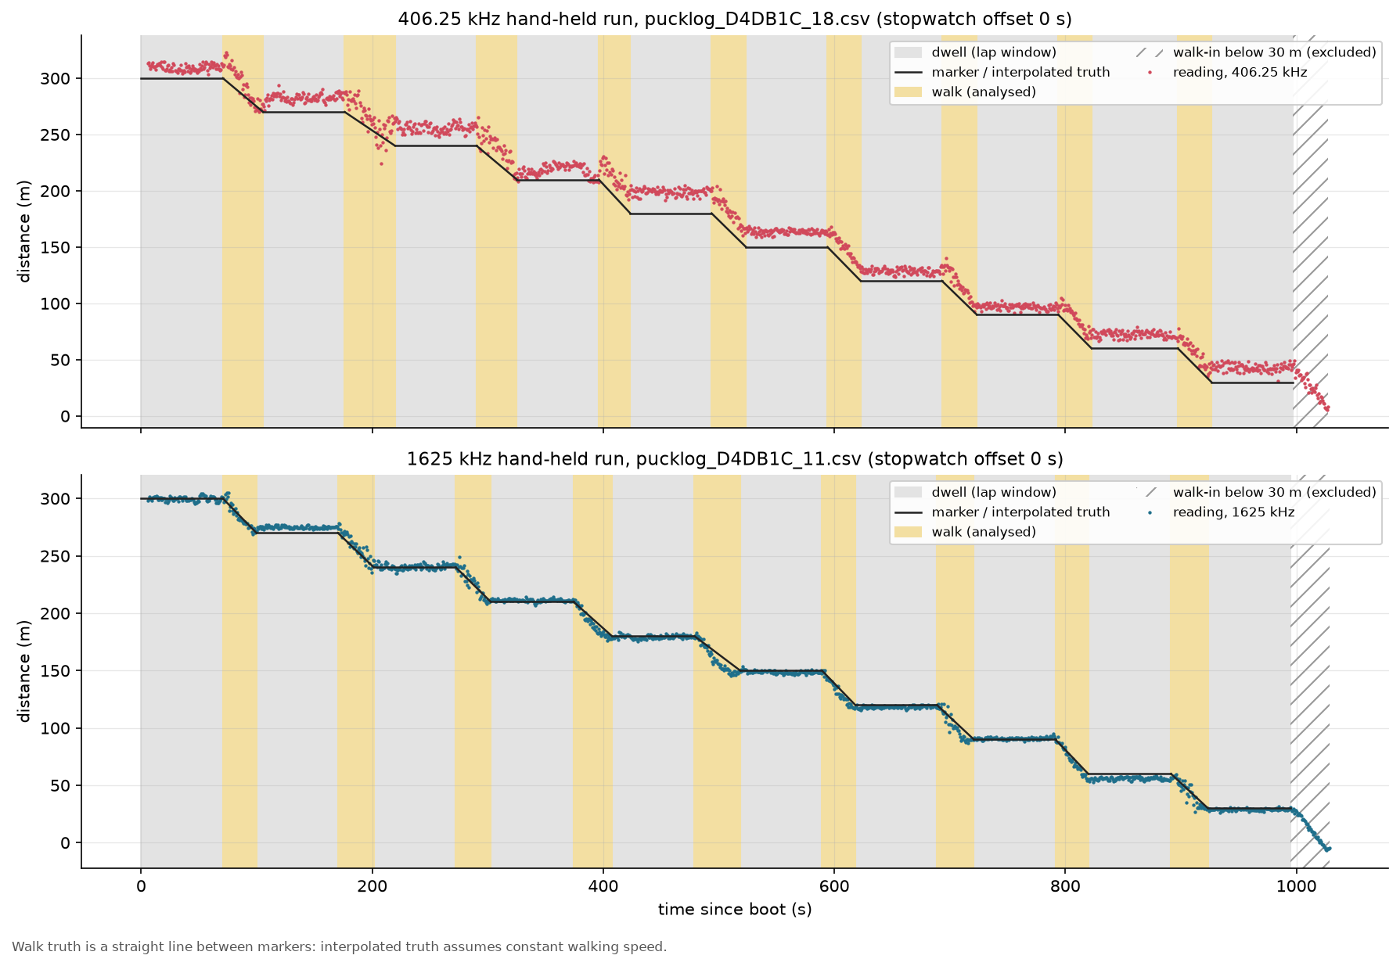
data/analysis/figures/c2_walking.png
