raonka/Pack-Puck/data/analysis/figures/c2_walking_paper.png

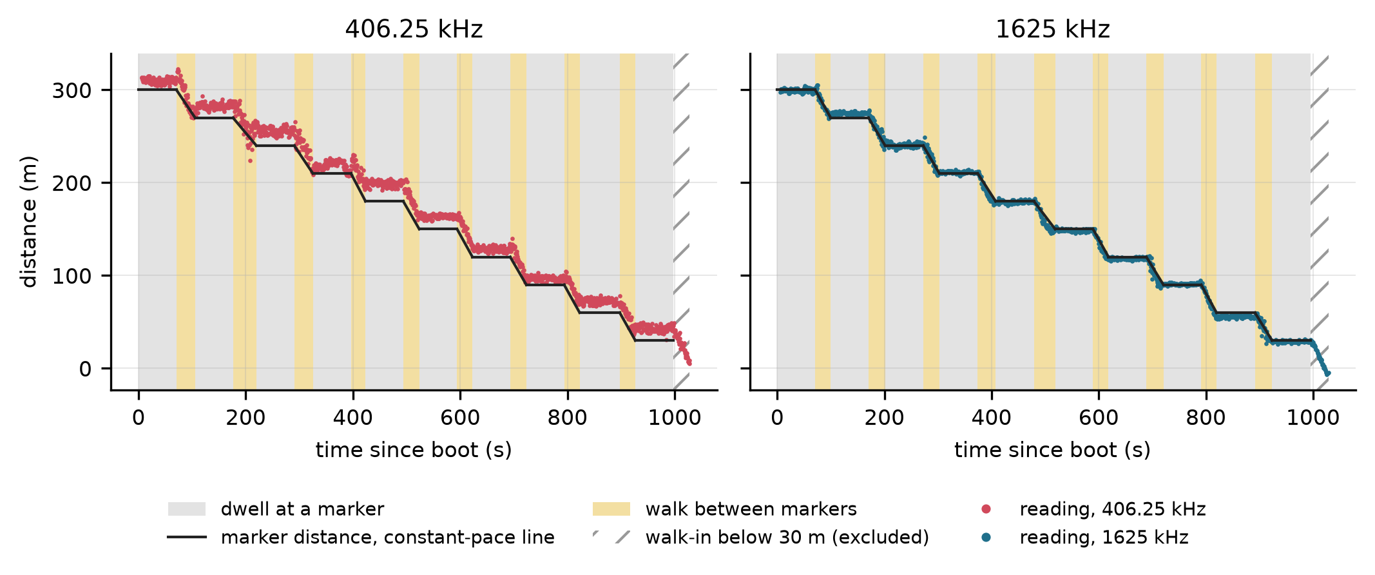
data/analysis/figures/c2_walking_paper.png
