raonka/Pack-Puck/data/ranging_experiments/2026-07-13_ParadeGround_pilot/environment/README.md

# Environmental record

Weather observations for this outing: screenshots of the reading taken in the
field, and any transcription of them into the session log.

Fields the session log expects: TEMP_C, HUMIDITY_PCT, WEATHER, WIND, RF_ENV_NOTES.
