raonka/Pack-Puck/data/ranging_experiments/2026-07-13_ParadeGround_pilot/raw/20260713_073950-Initiator/pucklog_D4DB1C_1.csv

# CSV_SCHEMA_V=1 | FW=0.9-field-hardening | BOARD_ID=0x541BBDD4DB1C | ROLE=INITIATOR | BOOT_MS=0 | FREQ=2400.0 | BW=1625.00 | SF=8 | CR=7 | TXPOWER=12
seq | timestamp_ms | status | raw_distance_m | rssi_dbm | state | consecutive_failures | radio_status_code
1 | 5899 | SUCCESS | 25.1502 | -63 | DISPLAY | 0 | 0
2 | 6554 | SUCCESS | 26.4348 | -68 | DISPLAY | 0 | 0
3 | 7210 | SUCCESS | 24.0685 | -69 | DISPLAY | 0 | 0
4 | 7866 | SUCCESS | 23.8657 | -65 | DISPLAY | 0 | 0
5 | 8521 | SUCCESS | 24.4967 | -71 | DISPLAY | 0 | 0
6 | 9177 | SUCCESS | 25.6235 | -63 | DISPLAY | 0 | 0
7 | 9832 | SUCCESS | 25.1728 | -62 | DISPLAY | 0 | 0
8 | 10488 | SUCCESS | 25.2404 | -65 | DISPLAY | 0 | 0
9 | 11143 | SUCCESS | 25.5108 | -64 | DISPLAY | 0 | 0
10 | 11799 | SUCCESS | 19.1782 | -76 | DISPLAY | 0 | 0
11 | 12459 | SUCCESS | 25.0601 | -74 | DISPLAY | 0 | 0
12 | 13114 | SUCCESS | 26.2320 | -72 | DISPLAY | 0 | 0
13 | 13769 | SUCCESS | 24.4742 | -75 | DISPLAY | 0 | 0
14 | 14425 | SUCCESS | 25.8263 | -71 | DISPLAY | 0 | 0
15 | 15080 | SUCCESS | 22.2431 | -72 | DISPLAY | 0 | 0
16 | 15735 | SUCCESS | 23.4150 | -70 | DISPLAY | 0 | 0
17 | 16391 | SUCCESS | 27.5165 | -65 | DISPLAY | 0 | 0
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
