raonka/Pack-Puck/data/ranging_experiments/2026-07-13_ParadeGround_pilot/raw/20260713_073950-Initiator/pucklog_D4DB1C_2.csv

# CSV_SCHEMA_V=1 | FW=0.9-field-hardening | BOARD_ID=0x541BBDD4DB1C | ROLE=INITIATOR | BOOT_MS=0 | FREQ=2400.0 | BW=1625.00 | SF=8 | CR=7 | TXPOWER=12
seq | timestamp_ms | status | raw_distance_m | rssi_dbm | state | consecutive_failures | radio_status_code
1 | 5899 | SUCCESS | 58.3684 | -70 | DISPLAY | 0 | 0
2 | 6554 | SUCCESS | 60.2614 | -71 | DISPLAY | 0 | 0
3 | 7210 | SUCCESS | 58.4585 | -71 | DISPLAY | 0 | 0
4 | 7865 | SUCCESS | 56.4979 | -72 | DISPLAY | 0 | 0
5 | 8521 | SUCCESS | 59.0895 | -72 | DISPLAY | 0 | 0
6 | 9177 | SUCCESS | 55.7993 | -73 | DISPLAY | 0 | 0
7 | 9832 | SUCCESS | 59.2924 | -72 | DISPLAY | 0 | 0
8 | 10488 | SUCCESS | 53.9062 | -73 | DISPLAY | 0 | 0
9 | 11143 | SUCCESS | 50.8639 | -74 | DISPLAY | 0 | 0
10 | 11799 | SUCCESS | 38.8296 | -74 | DISPLAY | 0 | 0
11 | 12459 | SUCCESS | 46.4017 | -73 | DISPLAY | 0 | 0
12 | 13115 | SUCCESS | 50.2779 | -73 | DISPLAY | 0 | 0
13 | 13770 | SUCCESS | 49.9174 | -73 | DISPLAY | 0 | 0
14 | 14426 | SUCCESS | 48.8807 | -71 | DISPLAY | 0 | 0
15 | 15081 | SUCCESS | 42.5706 | -71 | DISPLAY | 0 | 0
16 | 15737 | SUCCESS | 34.5252 | -77 | DISPLAY | 0 | 0
17 | 16392 | SUCCESS | 31.7308 | -76 | DISPLAY | 0 | 0
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
