raonka/Pack-Puck/data/ranging_experiments/2026-07-13_ParadeGround_pilot/raw/20260713_073950-Initiator/pucklog_D4DB1C_3.csv

# CSV_SCHEMA_V=1 | FW=0.9-field-hardening | BOARD_ID=0x541BBDD4DB1C | ROLE=INITIATOR | BOOT_MS=0 | FREQ=2400.0 | BW=1625.00 | SF=8 | CR=7 | TXPOWER=12
seq | timestamp_ms | status | raw_distance_m | rssi_dbm | state | consecutive_failures | radio_status_code
1 | 5899 | SUCCESS | 110.5844 | -84 | DISPLAY | 0 | 0
2 | 6554 | SUCCESS | 107.9702 | -85 | DISPLAY | 0 | 0
3 | 7210 | SUCCESS | 107.5421 | -84 | DISPLAY | 0 | 0
4 | 7865 | SUCCESS | 105.1758 | -81 | DISPLAY | 0 | 0
5 | 8521 | TIMEOUT | NaN | 0 | RANGING | 1 | -901
6 | 19166 | SUCCESS | 115.0916 | -77 | DISPLAY | 0 | 0
7 | 19822 | SUCCESS | 107.0012 | -76 | DISPLAY | 0 | 0
8 | 20477 | SUCCESS | 100.7362 | -76 | DISPLAY | 0 | 0
9 | 21133 | SUCCESS | 97.8966 | -76 | DISPLAY | 0 | 0
10 | 21788 | SUCCESS | 87.2371 | -77 | DISPLAY | 0 | 0
11 | 22449 | SUCCESS | 39.1001 | -89 | DISPLAY | 0 | 0
12 | 23105 | SUCCESS | 55.6190 | -86 | DISPLAY | 0 | 0
13 | 23760 | SUCCESS | 25.3305 | -89 | DISPLAY | 0 | 0
14 | 24416 | SUCCESS | 54.5147 | -86 | DISPLAY | 0 | 0
15 | 25071 | SUCCESS | 70.9435 | -86 | DISPLAY | 0 | 0
16 | 25727 | SUCCESS | 55.8669 | -90 | DISPLAY | 0 | 0
17 | 26382 | SUCCESS | 81.3101 | -89 | DISPLAY | 0 | 0
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
