raonka/Pack-Puck/data/ranging_experiments/2026-07-13_ParadeGround_pilot/raw/20260713_073950-Initiator/pucklog_D4DB1C_4.csv

# CSV_SCHEMA_V=1 | FW=0.9-field-hardening | BOARD_ID=0x541BBDD4DB1C | ROLE=INITIATOR | BOOT_MS=0 | FREQ=2400.0 | BW=1625.00 | SF=8 | CR=7 | TXPOWER=12
seq | timestamp_ms | status | raw_distance_m | rssi_dbm | state | consecutive_failures | radio_status_code
1 | 5901 | SUCCESS | 142.6082 | -82 | DISPLAY | 0 | 0
2 | 6556 | SUCCESS | 151.6001 | -81 | DISPLAY | 0 | 0
3 | 7212 | SUCCESS | 156.3326 | -83 | DISPLAY | 0 | 0
4 | 7867 | SUCCESS | 171.5445 | -84 | DISPLAY | 0 | 0
5 | 8523 | SUCCESS | 143.4645 | -94 | DISPLAY | 0 | 0
6 | 9178 | SUCCESS | 158.6764 | -87 | DISPLAY | 0 | 0
7 | 9833 | SUCCESS | 102.6517 | -92 | DISPLAY | 0 | 0
8 | 10489 | SUCCESS | 156.9186 | -83 | DISPLAY | 0 | 0
9 | 11144 | SUCCESS | 134.9684 | -82 | DISPLAY | 0 | 0
10 | 11800 | SUCCESS | 127.8245 | -87 | DISPLAY | 0 | 0
11 | 12460 | SUCCESS | 155.4537 | -84 | DISPLAY | 0 | 0
12 | 13115 | SUCCESS | 179.1166 | -86 | DISPLAY | 0 | 0
13 | 13771 | SUCCESS | 172.8741 | -85 | DISPLAY | 0 | 0
14 | 14426 | SUCCESS | 169.1331 | -89 | DISPLAY | 0 | 0
15 | 15082 | SUCCESS | 159.1046 | -84 | DISPLAY | 0 | 0
16 | 15737 | SUCCESS | 163.8371 | -82 | DISPLAY | 0 | 0
17 | 16393 | SUCCESS | 162.4174 | -82 | DISPLAY | 0 | 0
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
