raonka/Pack-Puck/data/ranging_experiments/2026-07-13_ParadeGround_pilot/raw/20260713_073950-Initiator/pucklog_D4DB1C_5.csv

# CSV_SCHEMA_V=1 | FW=0.9-field-hardening | BOARD_ID=0x541BBDD4DB1C | ROLE=INITIATOR | BOOT_MS=0 | FREQ=2400.0 | BW=1625.00 | SF=8 | CR=7 | TXPOWER=12
seq | timestamp_ms | status | raw_distance_m | rssi_dbm | state | consecutive_failures | radio_status_code
1 | 5900 | SUCCESS | 226.5099 | -93 | DISPLAY | 0 | 0
2 | 6555 | SUCCESS | 192.3452 | -95 | DISPLAY | 0 | 0
3 | 7211 | SUCCESS | 210.0586 | -94 | DISPLAY | 0 | 0
4 | 7866 | SUCCESS | 209.1571 | -97 | DISPLAY | 0 | 0
5 | 8522 | SUCCESS | 237.1469 | -92 | DISPLAY | 0 | 0
6 | 9177 | SUCCESS | 222.0027 | -87 | DISPLAY | 0 | 0
7 | 9833 | SUCCESS | 247.0853 | -90 | DISPLAY | 0 | 0
8 | 10488 | SUCCESS | 207.4895 | -86 | DISPLAY | 0 | 0
9 | 11144 | SUCCESS | 222.3858 | -85 | DISPLAY | 0 | 0
10 | 11799 | SUCCESS | 181.8209 | -88 | DISPLAY | 0 | 0
11 | 12459 | SUCCESS | 178.8236 | -87 | DISPLAY | 0 | 0
12 | 13115 | SUCCESS | 188.0408 | -86 | DISPLAY | 0 | 0
13 | 13770 | SUCCESS | 179.3645 | -89 | DISPLAY | 0 | 0
14 | 14426 | SUCCESS | 185.7422 | -87 | DISPLAY | 0 | 0
15 | 15081 | SUCCESS | 197.4835 | -85 | DISPLAY | 0 | 0
16 | 15737 | SUCCESS | 206.0697 | -87 | DISPLAY | 0 | 0
17 | 16392 | SUCCESS | 230.5889 | -90 | DISPLAY | 0 | 0
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
