raonka/Pack-Puck/data/ranging_experiments/2026-07-13_ParadeGround_pilot/raw/20260713_073950-Initiator/pucklog_D4DB1C_6.csv

# CSV_SCHEMA_V=1 | FW=0.9-field-hardening | BOARD_ID=0x541BBDD4DB1C | ROLE=INITIATOR | BOOT_MS=0 | FREQ=2400.0 | BW=1625.00 | SF=8 | CR=7 | TXPOWER=12
seq | timestamp_ms | status | raw_distance_m | rssi_dbm | state | consecutive_failures | radio_status_code
1 | 5901 | TIMEOUT | NaN | 0 | RANGING | 1 | -901
2 | 16546 | SUCCESS | 275.5258 | -95 | DISPLAY | 0 | 0
3 | 17201 | SUCCESS | 273.6103 | -97 | DISPLAY | 0 | 0
4 | 17857 | SUCCESS | 274.8948 | -98 | DISPLAY | 0 | 0
5 | 18512 | SUCCESS | 268.3819 | -99 | DISPLAY | 0 | 0
6 | 19168 | SUCCESS | 255.4687 | -88 | DISPLAY | 0 | 0
7 | 19823 | SUCCESS | 257.0237 | -90 | DISPLAY | 0 | 0
8 | 20479 | SUCCESS | 274.4892 | -87 | DISPLAY | 0 | 0
9 | 21135 | SUCCESS | 269.4636 | -86 | DISPLAY | 0 | 0
10 | 21790 | SUCCESS | 252.3813 | -88 | DISPLAY | 0 | 0
11 | 22451 | SUCCESS | 243.7951 | -90 | DISPLAY | 0 | 0
12 | 23107 | SUCCESS | 249.9699 | -91 | DISPLAY | 0 | 0
13 | 23762 | SUCCESS | 260.1562 | -90 | DISPLAY | 0 | 0
14 | 24418 | SUCCESS | 256.9561 | -90 | DISPLAY | 0 | 0
15 | 25074 | SUCCESS | 280.9119 | -90 | DISPLAY | 0 | 0
16 | 25729 | SUCCESS | 263.7620 | -90 | DISPLAY | 0 | 0
17 | 26385 | SUCCESS | 226.8029 | -90 | DISPLAY | 0 | 0
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
