raonka/Pack-Puck/data/ranging_experiments/2026-07-13_ParadeGround_pilot/environment/Screenshot_20260713-071241.png

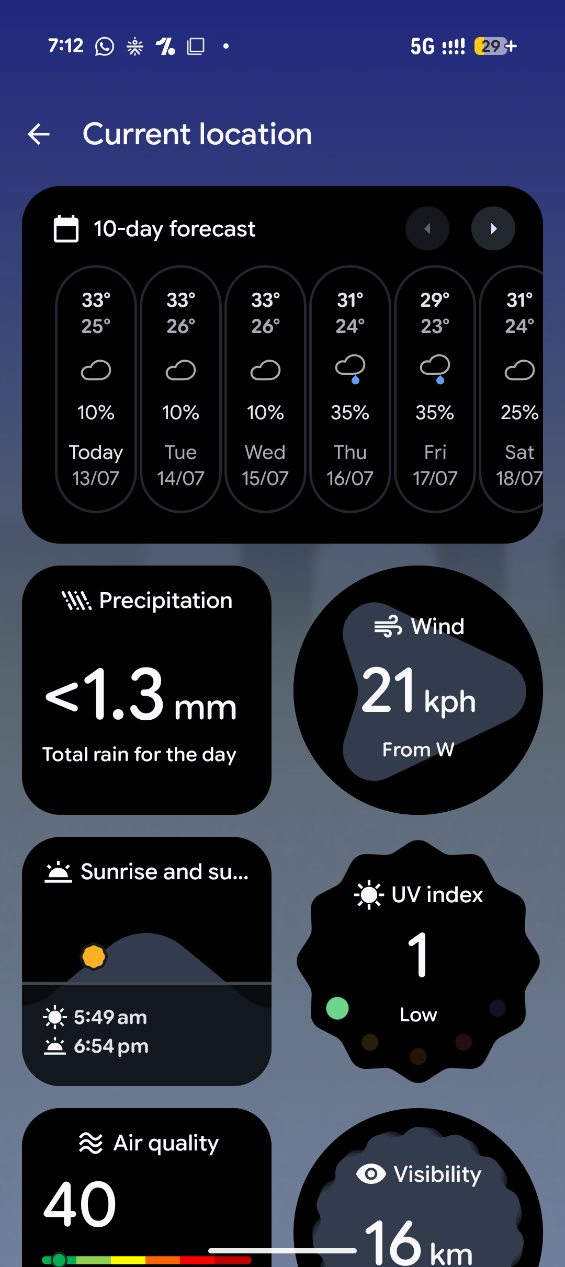
data/ranging_experiments/2026-07-13_ParadeGround_pilot/environment/Screenshot_20260713-071241.png
