raonka/Pack-Puck/data/ranging_experiments/2026-08-15_GMATownship_session01/environment/Screenshot_20260815-182738.png

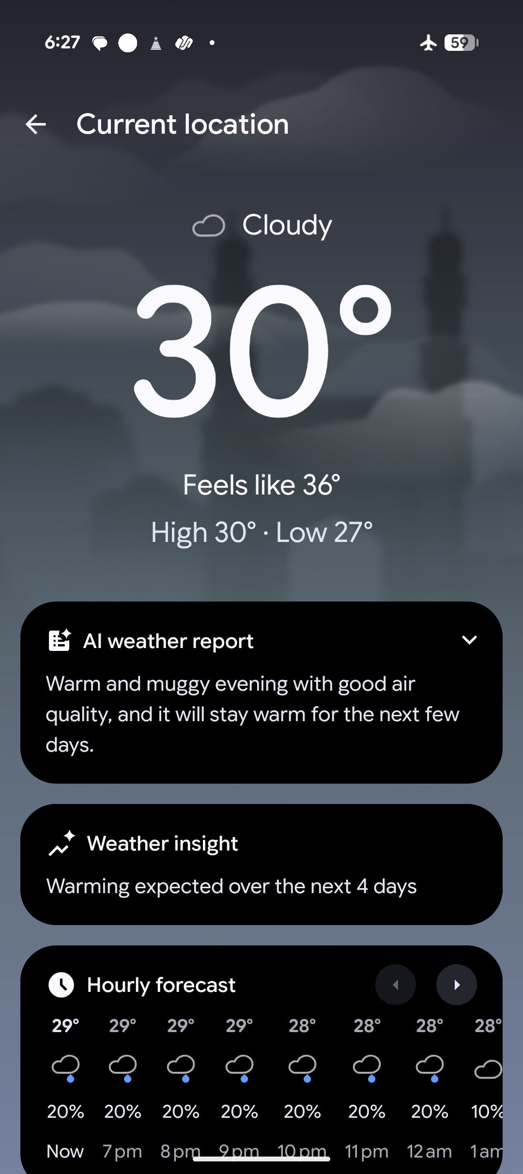
data/ranging_experiments/2026-08-15_GMATownship_session01/environment/Screenshot_20260815-182738.png
