raonka/Pack-Puck/data/ranging_experiments/2026-08-22_GMATownship_session02/environment/Screenshot_20260822-164308.png

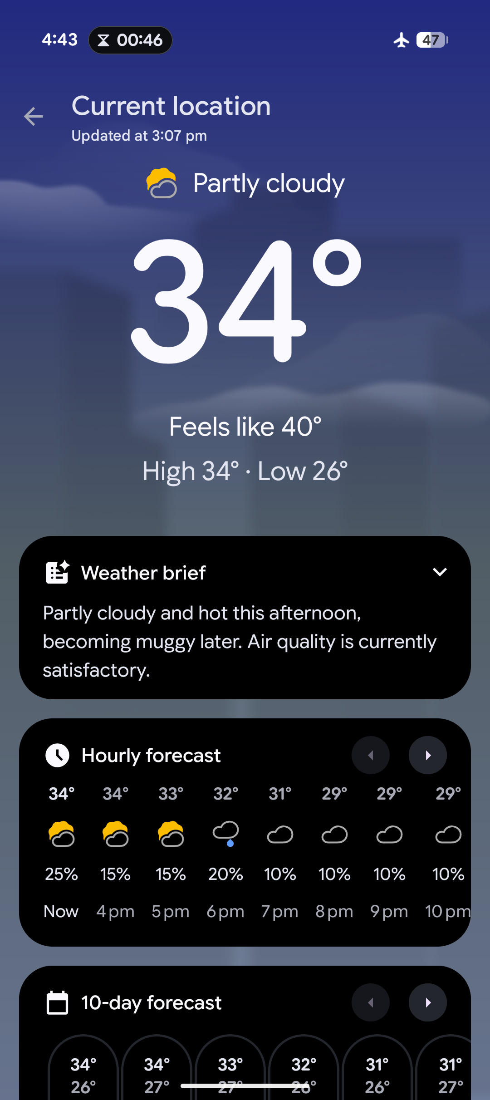
data/ranging_experiments/2026-08-22_GMATownship_session02/environment/Screenshot_20260822-164308.png
