raonka/Pack-Puck/data/analysis/c4_failure_modes.md

# Pack Pucks — C4 link behaviour and disturbance observations (22 Aug 2026; pilot-grade timeouts from 13 Jul)

Generated by `tools/c4_failure_modes.py`. Raw CSVs read-only. **Numbers only.**

## Inputs

- 406.25 kHz: `data/ranging_experiments/2026-08-22_GMATownship_session02/raw/20260822_162424-Initiator/`, plan `data/analysis/2026-08-22_GMATownship_162424_qc/session_plan.json`, laps `data/ranging_experiments/2026-08-22_GMATownship_session02/stopwatch_laps_data_406.csv`
- 1625 kHz: `data/ranging_experiments/2026-08-22_GMATownship_session02/raw/20260822_174415-Initiator/`, plan `data/analysis/2026-08-22_GMATownship_174415_qc/session_plan.json`, laps `data/ranging_experiments/2026-08-22_GMATownship_session02/stopwatch_laps_data_1625.csv`
- Marker windows (post-discard): `tools/per_marker_tables.py` → `data/analysis/2026-08-22_GMATownship_day2_tables_discard5s.md`

Scopes:
- **(a) windows** = post-discard marker windows, the rows behind every per-marker table.
- **(b) kept files** = every row of the run's kept files, including the first 5 s and, for stop-and-go, the walk transits.
- **Retakes** = operator-discarded files, reported separately.

## 1. Outcomes, status codes, consecutive failures

| BW kHz | tier | scope | rows | SUCCESS | TIMEOUT | ERROR | radio_status_code values (count) | max consecutive_failures |
|---|---|---|---|---|---|---|---|---|
| 406.25 | static | (b) kept files (10 files) | 950 | 950 | 0 | 0 | 0 (950) | 0 |
| 406.25 | static | retakes (4 files) | 250 | 250 | 0 | 0 | 0 (250) | 0 |
| 406.25 | stop-and-go | (b) kept files (1 file) | 1490 | 1490 | 0 | 0 | 0 (1490) | 0 |
| 406.25 | stop-and-go | retakes (1 file) | 410 | 410 | 0 | 0 | 0 (410) | 0 |
| 1625 | static | (b) kept files (10 files) | 1100 | 1100 | 0 | 0 | 0 (1100) | 0 |
| 1625 | stop-and-go | (b) kept files (1 file) | 1560 | 1560 | 0 | 0 | 0 (1560) | 0 |

Totals over kept files, all four runs: SUCCESS 5100, TIMEOUT 0, ERROR 0. Including the operator-discarded retakes: 5760 attempts, SUCCESS 5760, TIMEOUT 0, ERROR 0.

## 2. Implausible readings

Negative = `raw_distance_m` < 0. Far = |reading − marker truth| > 50 m (only where truth is defined).

| BW kHz | tier | scope | negative (count) | negative at | far (count) | far at |
|---|---|---|---|---|---|---|
| 406.25 | static | (b) kept files | 0 | — | 0 | — |
| 406.25 | static | (a) windows | 0 | — | 0 | — |
| 406.25 | stop-and-go | (b) kept files | 0 | — | n/a | n/a (no truth in transits) |
| 406.25 | stop-and-go | (a) windows | 0 | — | 0 | — |
| 1625 | static | (b) kept files | 0 | — | 0 | — |
| 1625 | static | (a) windows | 0 | — | 0 | — |
| 1625 | stop-and-go | (b) kept files | 12 | outside dwell windows (transit): -0.1 m @ 1019.9 s, -1.3 m @ 1021.9 s, -1.8 m @ 1022.6 s, -1.8 m @ 1023.2 s, -3.6 m @ 1023.9 s, -4.2 m @ 1024.5 s, -6.0 m @ 1025.2 s, -6.6 m @ 1025.8 s, -5.3 m @ 1026.5 s, -5.6 m @ 1027.2 s, -5.1 m @ 1027.8 s, -4.8 m @ 1028.5 s | n/a | n/a (no truth in transits) |
| 1625 | stop-and-go | (a) windows | 0 | — | 0 | — |

## 3. Initiator RSSI

Validity test: SUCCESS rows whose `rssi_dbm` is not 0 (TIMEOUT/ERROR convention) or −150 (ranging-RSSI register read back 0), with more than one distinct value per run.

| BW kHz | tier | SUCCESS rows (kept files) | invalid values | distinct values | range dBm | valid? |
|---|---|---|---|---|---|---|
| 406.25 | static | 950 | 0 | 31 | -91 to -56 | yes |
| 406.25 | stop-and-go | 1490 | 0 | 47 | -93 to -16 | yes |
| 1625 | static | 1100 | 0 | 28 | -95 to -68 | yes |
| 1625 | stop-and-go | 1560 | 0 | 46 | -96 to -30 | yes |

Responder RSSI is not covered here: it is constant −150 on the 406.25 Responder log and absent for 1625 (22 Aug session log D8).

### Spearman correlation, RSSI vs |error| (post-discard SUCCESS rows)

|error| = |raw_distance_m − marker|. Both RSSI and marker distance change along the line, so the pooled coefficient mixes the distance trend with any within-marker relationship. The within-marker column holds distance fixed.

| BW kHz | scope | n rows | Spearman ρ (pooled) | median within-marker ρ | within-marker ρ range |
|---|---|---|---|---|---|
| 406.25 | both tiers pooled | 1817 | -0.05 | +0.03 | -0.50 to +0.48 |
| 406.25 | static | 870 | +0.02 | -0.05 | -0.50 to +0.33 |
| 406.25 | stop-and-go | 947 | -0.14 | +0.09 | -0.24 to +0.48 |
| 1625 | both tiers pooled | 2015 | -0.17 | +0.04 | -0.69 to +0.36 |
| 1625 | static | 1020 | -0.21 | +0.00 | -0.23 to +0.36 |
| 1625 | stop-and-go | 995 | -0.12 | +0.04 | -0.69 to +0.20 |

### Median initiator RSSI per marker (dBm, post-discard SUCCESS rows)

| marker m | 406.25 static | 406.25 s&g | 1625 static | 1625 s&g |
|---|---|---|---|---|
| 30 | -66 | -66 | -70 | -72 |
| 60 | -71 | -72 | -75 | -75 |
| 90 | -72 | -71 | -75 | -76 |
| 120 | -75 | -76 | -77 | -79 |
| 150 | -79 | -77 | -80 | -81 |
| 180 | -87 | -83 | -82 | -85 |
| 210 | -87 | -85 | -86 | -87 |
| 240 | -88 | -86 | -89 | -88 |
| 270 | -89 | -88 | -90 | -88 |
| 300 | -89 | -87 | -90 | -90 |

## 4. Operator-discarded retakes (disturbances), 22 Aug

Reasons are quoted verbatim from the operator-confirmed session plans (field notes). Retake and kept statistics both use the Methodology §7.2 first-5-s discard; N = post-discard attempts, all SUCCESS.

| BW kHz | tier | marker m | retake file | reason (verbatim) | retake N | retake median m | retake IQR m | retake min–max m | kept median m | kept IQR m | kept min–max m |
|---|---|---|---|---|---|---|---|---|---|---|---|
| 406.25 | static | 120 | `pucklog_D4DB1C_4.csv` | field notes (2026-08-22): '120m  retake - Puck tripod fall'. Superseded by pucklog_D4DB1C_5.csv | 62 | 136.2 | 3.9 | 129.9–140.6 | 134.0 | 3.1 | 129.0–138.8 |
| 406.25 | static | 150 | `pucklog_D4DB1C_6.csv` | field notes (2026-08-22): '150m retake - car interference.' Superseded by pucklog_D4DB1C_7.csv | 12 | 163.9 | 2.7 | 159.5–166.1 | 162.1 | 4.1 | 156.2–166.4 |
| 406.25 | static | 240 | `pucklog_D4DB1C_10.csv` | field notes (2026-08-22): '240m - retake - Buffalo walked in.' Superseded by pucklog_D4DB1C_11.csv | 82 | 266.0 | 7.2 | 218.0–280.2 | 269.7 | 6.4 | 258.7–281.4 |
| 406.25 | static | 300 | `pucklog_D4DB1C_13.csv` | field notes (2026-08-22): '300m - Retake before of interference.' Superseded by pucklog_D4DB1C_14.csv ('300m - Shrub and House Rerun.') | 62 | 307.5 | 3.2 | 301.9–312.9 | 304.6 | 4.1 | 296.0–313.2 |
| 406.25 | stop-and-go | 300→ (partial run) | `pucklog_D4DB1C_15.csv` | field notes (2026-08-22): '--406 Stop & Go Run-- Done Twice first rejected.' First attempt, abandoned after the 300 m dwell and part of the descent; superseded by pucklog_D4DB1C_18.csv | 410 rows, 410 SUCCESS (whole file) | — | — | 243.9–327.1 | — | — | — |

## 5. Pilot outing timeouts (2026-07-13, pilot-grade)

`data/ranging_experiments/2026-07-13_ParadeGround_pilot/raw/20260713_073950-Initiator/`: 1625 kHz / SF8, positions paced, **no surveyed ground truth**; reported for link behaviour only. Cycle length = timestamp of the row minus timestamp of the previous row.

| file | rows | SUCCESS | TIMEOUT | ERROR | status codes (count) | TIMEOUT cycle lengths s | median SUCCESS cycle ms |
|---|---|---|---|---|---|---|---|
| `pucklog_D4DB1C_1.csv` | 120 | 120 | 0 | 0 | 0 (120) | — | 655 |
| `pucklog_D4DB1C_2.csv` | 120 | 120 | 0 | 0 | 0 (120) | — | 655 |
| `pucklog_D4DB1C_3.csv` | 100 | 99 | 1 | 0 | -901 (1), 0 (99) | 0.7 | 655 |
| `pucklog_D4DB1C_4.csv` | 100 | 100 | 0 | 0 | 0 (100) | — | 656 |
| `pucklog_D4DB1C_5.csv` | 80 | 79 | 1 | 0 | -901 (1), 0 (79) | 0.7 | 656 |
| `pucklog_D4DB1C_6.csv` | 70 | 68 | 2 | 0 | -901 (2), 0 (68) | 0.7 | 655 |
| `pucklog_D4DB1C_8.csv` | 100 | 98 | 2 | 0 | -901 (2), 0 (98) | 0.7, 0.7 | 656 |
| `pucklog_D4DB1C_9.csv` | 90 | 90 | 0 | 0 | 0 (90) | — | 656 |

Pilot totals: 780 attempts; SUCCESS 774, TIMEOUT 6, ERROR 0. Every TIMEOUT row carries status code −901 (RadioLib ranging timeout). TIMEOUT cycle lengths 0.7–0.7 s.
