raonka/Pack-Puck/(commit log)

2026-05-14 feat: phase 4 ranging with OLED display, no filter, no negative clamp
2026-05-18 feat: Phase 4.6-4.7 — WiFi/BT off, boot banner, SPIFFS CSV logging
    - FR-1.6: WiFi.mode(WIFI_OFF) + btStop() at boot; FAULT if either fails
    - Boot banner with FW_VERSION, BOARD_ID, WIFI_OFF, BT_OFF, SPIFFS_FILE
    - DR-1/DR-2: extended CSV schema (seq, raw_distance_m, state,
    consecutive_failures, radio_status_code)
    - SPIFFS on-device logging, one file per boot, flush every 10 cycles
    - Serial commands: LIST, DUMP, DELETE, FORMAT
    - FW_VERSION bumped to 0.5-spiffs-logging
    [03_initiator.ino, 03_responder.ino]
2026-05-19 fix: remove ranging delay — radio.range() already takes ~648ms at SF6/BW1625
    Observed cycle time was ~1148ms (~0.87 Hz) due to delay(500) stacking on
    top of the ~648ms blocking ranging call. Removing delay gives ~1.5 Hz,
    closer to the FR-2.1 2 Hz target. Cycle time measured from SPIFFS CSV
    timestamps during Phase 4.7.4 bench dry-run (19 May 2026).
    [03_initiator.ino]
2026-05-21 docs: FSD v1.2 — targeted clarifications
    Pair-only scope, Initiator-only LED display, raw_distance_m/NaN semantics,
    operator metadata RUN_ID + TRUE_DISTANCE_M rename, SPIFFS filename pattern,
    and RADIO_POWER (12 dBm firmware / ~12.5 dBm H594 hardware max).
2026-05-21 fix: firmware refinements v0.6 — TX power 12 dBm, flush cadence, DUMP buffer, fault ordering
    - setOutputPower(12) added to both sketches; begin() default was 10 dBm (IR-3.8)
    - Responder flushLog() now counts logged rows not loop iterations (FR-5.4)
    - DUMP command uses 256-byte batched reads instead of byte-at-a-time
    - WiFi/BT check moved before initSpiffs() to avoid empty CSV on fault (BR-1.5)
    - RADIOLIB_ERR_RANGING_TIMEOUT replaces magic number -901
    - #warning added to catch ENABLE_DISPLAY left on in demo builds (FSD 6.2)
    - FW_VERSION bumped to 0.6-tx-power
    [03_initiator.ino, 03_responder.ino]
2026-05-21 fix: explicitly set CR 4/7 and add to boot banner (IR-3.5)
    - radio.begin() cr=7 now explicit in both sketches (was implicit default)
    - CR 4/7 confirmed: RadioLib cr=7 -> codingRateLoRa=3 -> register 0x03
    - Boot banner updated: RADIO line now includes CR 4/7
    - Docs (FSD IR-3.5, methodology s3) to be updated separately in main repo
    [03_initiator.ino, 03_responder.ino]
2026-05-22 feat: v0.7-offload-mode — offload boot path, LIST framing, radio config #defines, per-CSV radio header
    - OFFLOAD boot mode (FR-5.7): 3 s mode-select window at boot; OFFLOAD\n skips
    ranging loop, no pucklog file opened, Serial command processor only
    - LIST command now framed (---BEGIN LIST--- / ---END LIST---) with one
    '<filename> <size_bytes>' row per line for offload script consumption
    - Radio config extracted into #defines (RADIO_FREQ_MHZ, RADIO_BW_KHZ,
    RADIO_SF, RADIO_CR, RADIO_TX_POWER_DBM) — single source for radio.begin(),
    boot banner, and per-CSV header line
    - Firmware-written CSV header line 1 now includes FREQ/BW/SF/CR/TXPOWER
    so each file is self-describing across fir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
    [03_initiator.ino, 03_responder.ino]
2026-05-22 feat: tools/offload — automated post-session SPIFFS offload script
    tools/offload/offload.py (Python 3 + pyserial):
    - Opens port with retry (waits up to 60 s for puck to appear)
    - Sends OFFLOAD on banner header detection — no pre-banner blind send,
    no stub file created for the offload boot
    - Downloads all SPIFFS files byte-exact via framed DUMP protocol
    - Retry prompt for SIZE_MISMATCH / SKIPPED files before FORMAT
    - FORMAT prompt after clean offload (literal YES required)
    - Local-time session folders; manifest.txt per session
    - Lazy session dir creation — failed/aborted runs leave no empty folders
    - Exit codes 0/1/2/3/4/130 for automation
    [offload.py]
2026-05-22 feat(offload): operator metadata, IST→UTC, role-tagged folder, early FORMAT, unplug countdown
    - Operator metadata prompts (methodology §4.1 / §4.4): session-wide (SITE,
    TIER, DATE, S<n>) once, then per-file (distance_or_run, TRUE_DISTANCE_M,
    BOOT_UTC_IST). Comma-separated input, re-prompts on missing/invalid params.
    Auto-derives SESSION_ID = <DATE>_<SITE>_<S<n>> and RUN_ID =
    <TIER>_<distance_or_run>_<S<n>>. --no-metadata flag bypasses prompts.
    - IST timestamps: accepts 'YYYY-MM-DD HH:MM:SS' or just 'HH:MM:SS' (today's
    IST date auto-fills). Subtracts 5:30 and writes ISO 8601 UTC to CSV line 2.
    - distance_or_run clarified as mode label: static distance ('100m') vs
    mobile run ('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
    [offload.py]
2026-05-23 docs: FSD v1.5 — operator-metadata automation note (no normative changes)
2026-06-09 config: lock Part 1 radio to SF8; document BW sweep + build modes
    RADIO_SF 6 -> 8 on both pucks (FSD IR-3.4, methodology §3, OD-RS-12).
    RADIO_BW_KHZ stays 1625.0f as default; comment block annotates that
    406.25f and 1625.0f are the only valid SX1280 values for the Part 1
    sweep (RadioLib rejects 400.0 / 1600.0 with INVALID_BANDWIDTH -8) and
    that the single line is flipped + reflashed per bandwidth run.
    Build-modes comment added by the radio-config #defines:
    collection - ENABLE_DISPLAY on, OLED is the in-field readout,
    LED ring not required; both bandwidths.
    demo - ENABLE_DISPLAY off, LED ring on, BW 1625.0f only.
    Boot banner and CSV firmware-written header line con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
    [03_initiator.ino, 03_responder.ino]
2026-06-22 fix: v0.9 firmware field-hardening for Part 1 data campaign
    - Log real ranging RSSI via SX1280 reg 0x0964 (dBm = reg-150). RadioLib
    getRSSI() returns 0 for ranging exchanges, which poisoned the
    RSSI-vs-quality analysis (C4.4). New SX1280Ranging subclass on both sketches.
    - FR-2.6/BR-3.1: ERROR now re-inits the radio and FAULTs after 3 failed
    attempts, instead of mislabelling rows state=FAULT and looping.
    - Loud SPIFFS-full failure: serial banner, OLED "!! SPIFFS FAIL !!", solid
    onboard LED; plus free-space report + low-space warning at boot (FSD 14.1).
    - FR-1.6: print WIFI_OFF/BT_OFF banner before faulting (regression from v0.7).
    - BW header/banner use %.2f so 406.25 is not logged as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
    [03_initiator.ino, 03_responder.ino]
2026-06-22 feat: offload integrity — schema validator gating FORMAT
    - Add tools/offload/validate_csv.py: validates downloaded CSVs against the
    methodology 4 / FSD DR-1/DR-2 schema (seq +1 monotonicity, timestamp order,
    NaN/RSSI conventions, FR-2.5 failure-counter bookkeeping, header fields).
    - offload.py runs it after the retry loop; a file failing validation is
    marked INVALID and blocks the post-offload FORMAT, so bad data is never
    wiped from the puck.
    - Size-scaled DUMP timeout (large files were un-offloadable under the fixed
    30 s cap) plus a 10 s inactivity cut-off.
    - IST date auto-fill now derives from UTC+5:30, not the laptop's local date.
    [offload.py, validate_csv.py]
2026-09-10 data: publish Part 1 ranging datasets, QC tool, and FSD v1.8
    First public release of the field data behind Part 1, together with the
    analysis script that produces every reported figure (contribution C1).
    Datasets (data/)
    - Raw CSVs exactly as offloaded, with their manifest byte-count records,
    for three outings:
    2026-07-13 Parade Ground, Hyderabad — pilot. Range progression over
    eight positions to a 365 m median. No ground truth: no
    tape survey was run, so no accuracy figure is derivable.
    Excluded from every reported result.
    2026-08-15 GMA township, Kota — 1625 kHz only, static and
    semi-mobile stop-and-go. Not co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
    [2026-07-13_ParadeGTest_T1_distance-52m_Initiator_S1_b3.csv, pucklog_D4DB1C_1.csv, pucklog_D4DB1C_10.csv, pucklog_D4DB1C_11.csv, pucklog_D4DB1C_12.csv, pucklog_D4DB1C_13.csv, pucklog_D4DB1C_14.csv, pucklog_D4DB1C_15.csv]
2026-10-26 tools, data: post-discard analysis scripts and outputs
    Per-marker tables with the Methodology 7.2 first-5-s discard, aggregates,
    post-hoc filters, link behaviour and disturbance observations, dwell table,
    bootstrap and slope intervals, and RSSI on the disturbed files, with the
    scripts that regenerate them and the discard5s README figures.
2026-10-26 docs: publish the ground-truth tolerance derivation
    Bound on the tape-surveyed cone positions at the GMA township marker line:
    inputs, terms, per-marker bounds, and the static and hand-held results.
2026-10-26 docs: update README and data README for the post-discard analysis
    Post-discard numbers with bootstrap intervals; single-session scoping and
    the 15 Aug disagreement; cycle-time direction; no timeout-guard claim;
    tripod / hand-held wording; literature table corrections; LED ring
    described as a demonstration build; ground-truth bound.
2026-11-10 docs: READMEs match the preprint; add licences
    README.md and data/README.md: endpoint roles and mounts (Initiator in a
    phone clamp on a carried 1.5 m tripod, Responder at the reference
    position, one power bank per puck); the 15 August session described only
    as exploratory validation data (the 9.0 m day-to-day comparison removed);
    walks described as analysed against a constant-pace reference; headline
    separates offset from spread (offset-removed MAE 6.2 / 3.1 against 1.7 m,
    spread 2.5 to 3.1 times wider); three contributions; hand-held bound
    +244 mm; pinned toolchain versions.
    LICENSE (MIT, firmware/ and tools/) and LICENSE-DATA (CC BY 4.0, data/,
    docs/ and the READMEs) added; the 'licence w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
2026-11-10 tools, data: publish the walking analysis, review follow-up and paper generators
    Adds tools/c2_walking.py and tools/review_followup.py with their outputs
    (data/analysis/c2_walking.md, review_followup.md, figures
    c2_walking*.png), the paper per-marker figure
    (bandwidth_accuracy_discard5s_paper.png, make_readme_figures.py
    fig_accuracy_paper), the current make_latex_tables.py and aggregates.py
    (and aggregates.md). docs/ground_truth_tolerance.md: sideways-term label
    corrected to 180/D, with a dated note; tabulated values unchanged.
2026-11-10 docs: README quick start and refresh
    New Quick start (hardware, build and flash with the pinned versions and
    board settings, running a session, offload with offload.py's actual
    options, the analysis sequence verified in a fresh clone) and a Paper and
    citation section. Flash step 4: the role is set by which sketch is
    flashed (03_initiator or 03_responder); there is no role flag. 'Why build
    it' moved before the paper section. All links and paths checked against
    main.
2026-11-10 data: complete 22 Aug session log fields; README fixes
    S2 session log: stale fields filled in place (filled 2026-11-11): mount
    height 150 cm measured on site; phone clamps on 1.5 m camera tripods,
    antennas vertical, pucks facing each other; hand-held carry (Initiator's
    tripod upright at full arm's length from behind, power bank in the
    operator's pocket); ground-truth bound pointer to
    docs/ground_truth_tolerance.md; weather screenshots in environment/;
    classification as the paper's data session (decision Oct 2026). Shrub and
    House entry: shrubs at 240 to 250 m tied back, same for both bandwidths.
    data/README.md and README.md: classification sentence points at the log
    field; Methodology.md av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
